oberrow/i8088-computer/kicad/Intel_8088_Computer/3dmodels/USB4110-GF-A.step

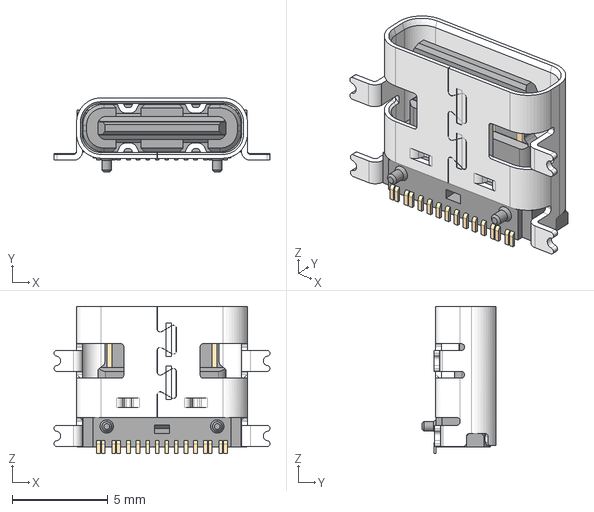
[picture p1: CAD file, 2026-07-20]
kicad/Intel_8088_Computer/3dmodels/USB4110-GF-A.step
11.3 x 3.89 x 7.70 mm
