oberrow/i8088-computer/kicad/Intel_8088_Computer/3dmodels/97503A111_Stainless Steel Phillips Oval Head Thread-Cutting Screws.STEP

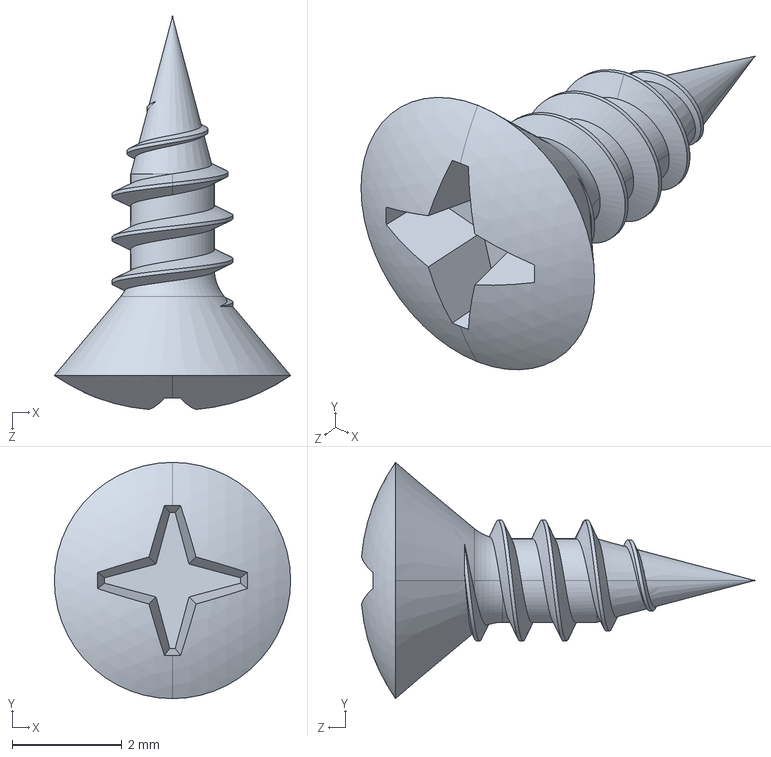
[picture p2: CAD file, 2026-07-20]
kicad/Intel_8088_Computer/3dmodels/97503A111_Stainless Steel Phillips Oval Head Thread-Cutting Screws.STEP
4.30 x 4.30 x 7.15 mm
