oberrow/i8088-computer/kicad/UART_Unit/UART_Unit.kicad_pcb

## KiCad design kicad/UART_Unit/UART_Unit.kicad_pcb (2026-07-20)

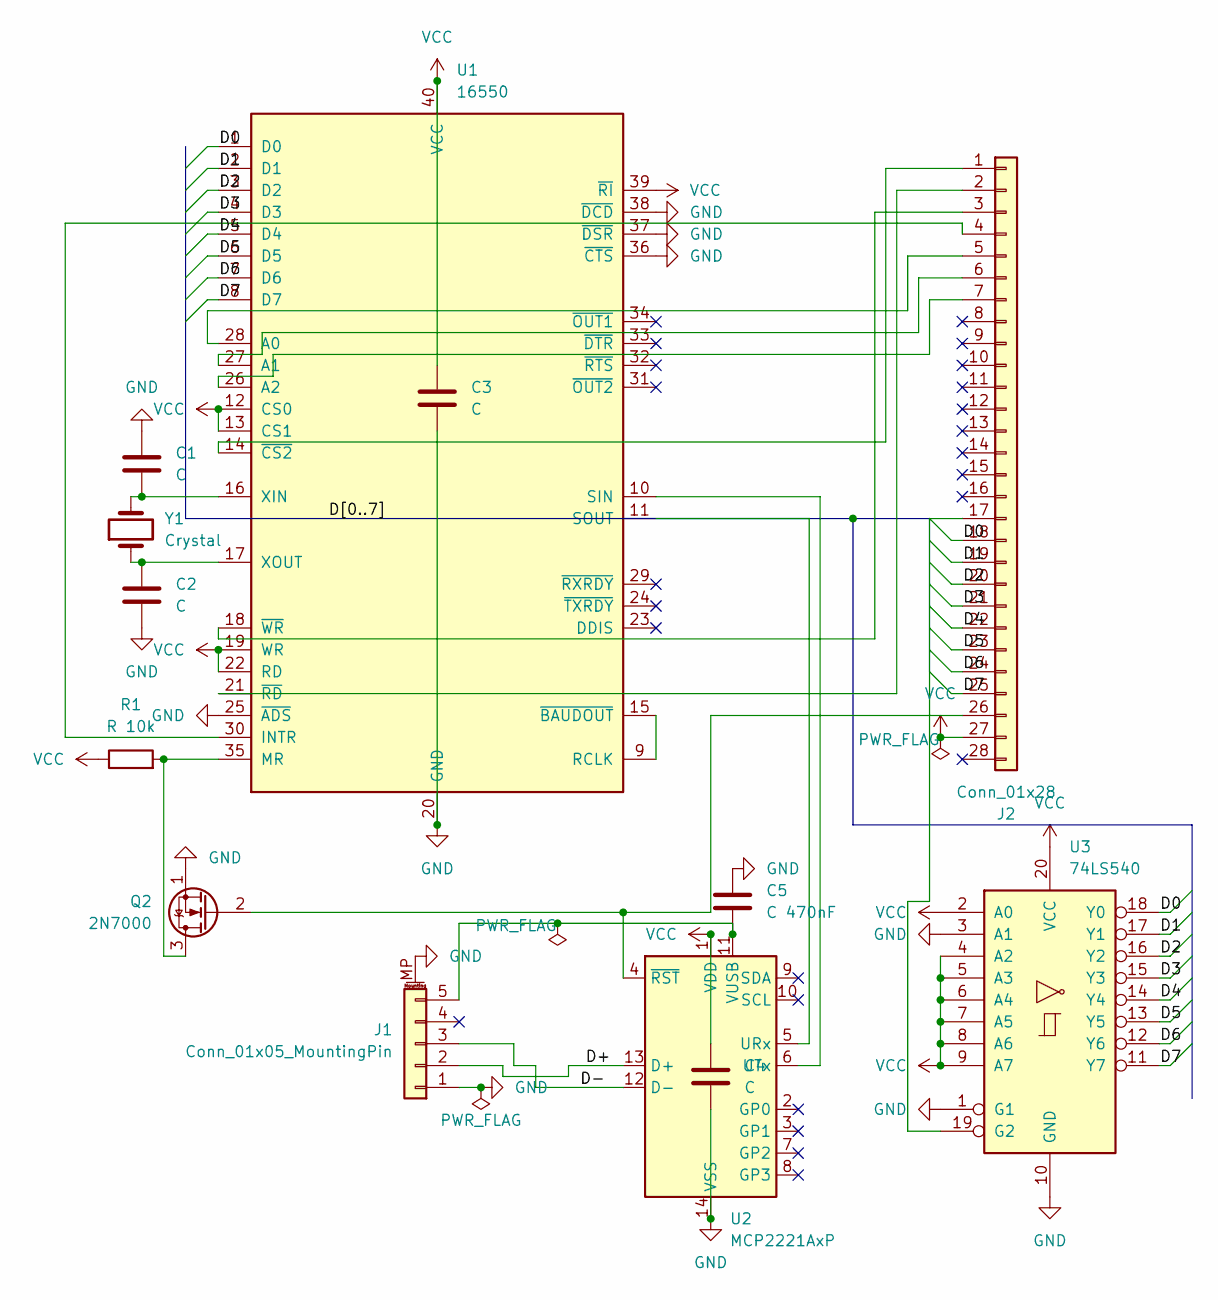
[picture p3: schematic UART_Unit.kicad_sch]

Parts:
C1, C2: C; C_Disc_D5.0mm_W2.5mm_P5.00mm
C3, C4: C; C_Disc_D5.0mm_W2.5mm_P2.50mm
C5: C 470nF; C_Disc_D5.0mm_W2.5mm_P2.50mm
J1: Conn_01x05_MountingPin; Molex_200528-0050_1x05-1MP_P1.00mm_Horizontal
J2: Conn_01x28; PinHeader_2x14_P2.54mm_Vertical
Q2: 2N7000; TO-92_Inline
R1: R 10k; R_Axial_DIN0207_L6.3mm_D2.5mm_P10.16mm_Horizontal
U1: 16550; DIP-40_W15.24mm
U2: MCP2221AxP; DIP-14_W7.62mm
U3: 74LS540; DIP-20_W7.62mm
Y1: Crystal; Crystal_HC49-U_Vertical

Connections:
/D0: J2.18, U1.1 (D0), U3.18 (Y0)
/D1: J2.19, U1.2 (D1), U3.17 (Y1)
/D2: J2.20, U1.3 (D2), U3.16 (Y2)
/D3: J2.21, U1.4 (D3), U3.15 (Y3)
/D4: J2.22, U1.5 (D4), U3.14 (Y4)
/D5: J2.23, U1.6 (D5), U3.13 (Y5)
/D6: J2.24, U1.7 (D6), U3.12 (Y6)
/D7: J2.25, U1.8 (D7), U3.11 (Y7)
/D+: J1.2, U2.13 (D+)
/D-: J1.3, U2.12 (D-)
GND: C1.1, C2.2, C3.2, C4.2, C5.1, J1.1, J1.MP (MountPin), Q2.1 (S), U1.20 (GND), U1.25 (~ADS), U1.36 (~CTS), U1.37 (~DSR), U1.38 (~DCD), U2.14 (VSS), U3.1 (G1), U3.3 (A1), U3.10 (GND)
unnamed: C5.2, J1.5, U2.11 (VUSB)
unnamed: J2.1, U1.14 (~CS2)
unnamed: J2.2, U1.21 (~RD)
unnamed: J2.3, U1.18 (~WR)
unnamed: J2.4, U1.30 (INTR)
unnamed: J2.5, U1.28 (A0)
unnamed: J2.6, U1.27 (A1)
unnamed: J2.7, U1.26 (A2)
unnamed: J2.17, U3.19 (G2)
unnamed: J2.26, Q2.2 (G), U2.4 (~RST)
unnamed: Q2.3 (D), R1.2, U1.35 (MR)
unnamed: U1.9 (RCLK), U1.15 (~BAUDOUT)
unnamed: U1.10 (SIN), U2.6 (UTx)
unnamed: U1.11 (SOUT), U2.5 (URx)
unnamed: C1.2, U1.16 (XIN), Y1.2
unnamed: C2.1, U1.17 (XOUT), Y1.1
VCC: C3.1, C4.1, J2.27, R1.1, U1.12 (CS0), U1.13 (CS1), U1.19 (WR), U1.22 (RD), U1.39 (~RI), U1.40 (VCC), U2.1 (VDD), U3.2 (A0), U3.4 (A2), U3.5 (A3), U3.6 (A4), U3.7 (A5), U3.8 (A6), U3.9 (A7), U3.20 (VCC)

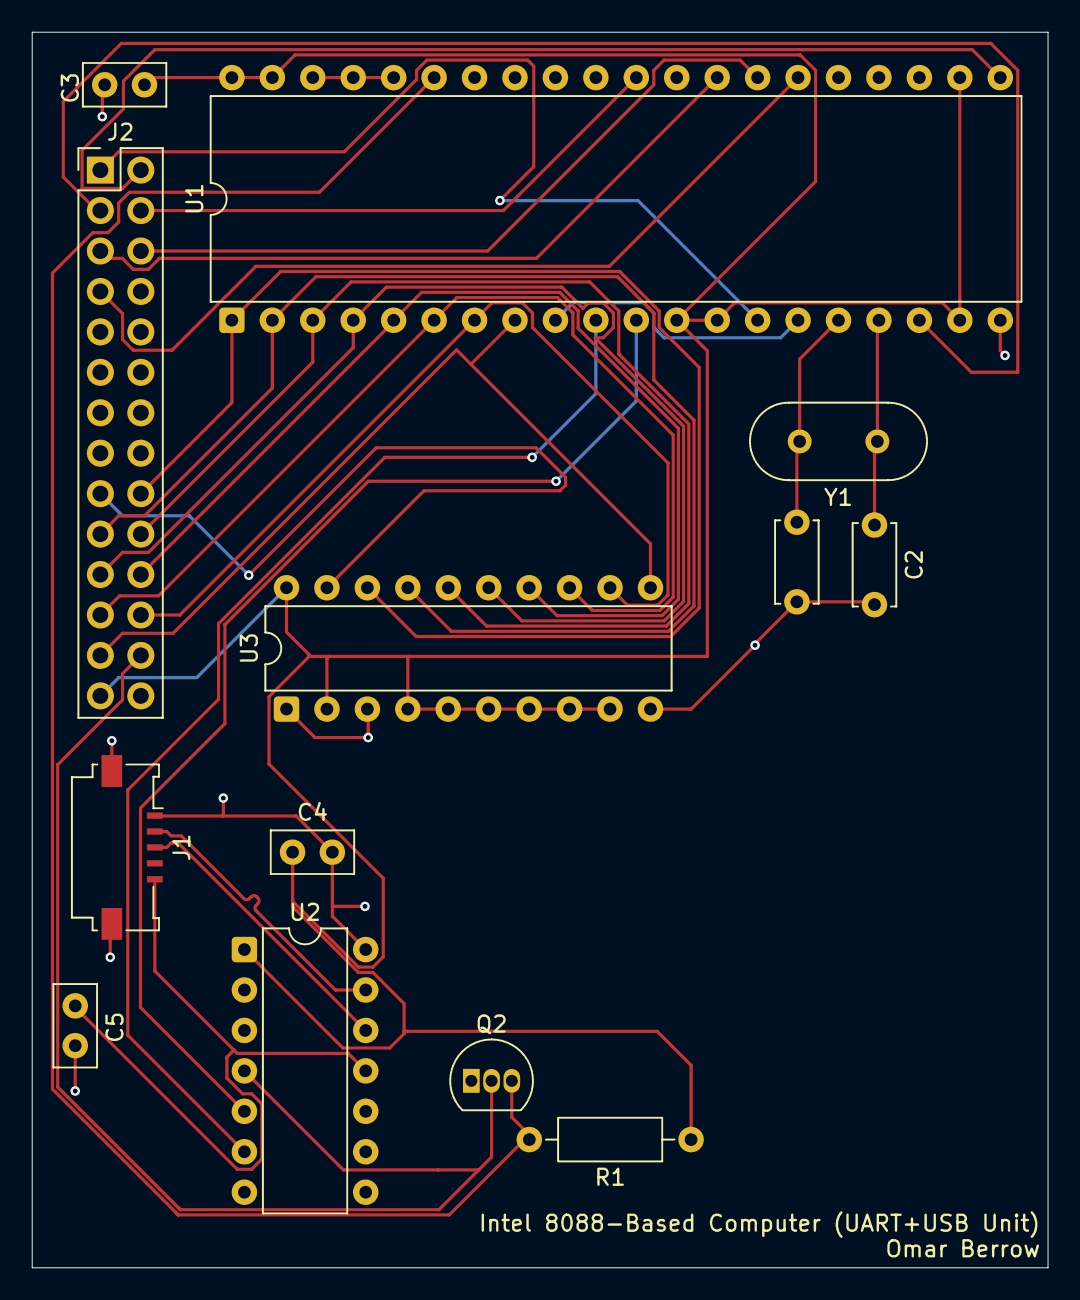
[picture p4: board UART_Unit.kicad_pcb from above]

Board: 2 copper layers, 63.8 x 77.6 mm, 13 parts (0 on the bottom side), 28 nets.
