oberrow/i8088-computer/kicad/AS6C1008_RAM_Unit/AS6C1008_RAM_Unit.kicad_pcb

## KiCad design kicad/AS6C1008_RAM_Unit/AS6C1008_RAM_Unit.kicad_pcb (2026-07-20)

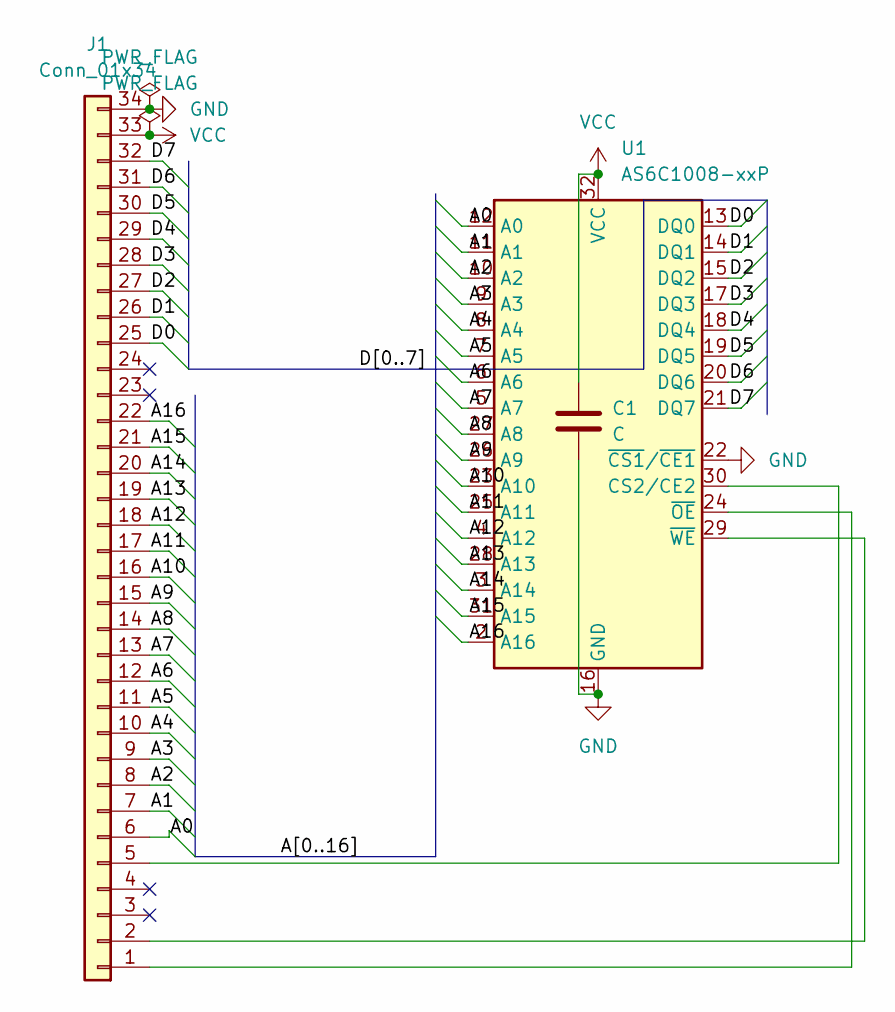
[picture p5: schematic AS6C1008_RAM_Unit.kicad_sch]

Parts:
C1: C; C_Disc_D5.0mm_W2.5mm_P2.50mm
J1: Conn_01x34; PinHeader_2x17_P2.54mm_Vertical
U1: AS6C1008-xxP; DIP-32_W15.24mm

Connections:
/A0: J1.6, U1.12 (A0)
/A1: J1.7, U1.11 (A1)
/A2: J1.8, U1.10 (A2)
/A3: J1.9, U1.9 (A3)
/A4: J1.10, U1.8 (A4)
/A5: J1.11, U1.7 (A5)
/A6: J1.12, U1.6 (A6)
/A7: J1.13, U1.5 (A7)
/A8: J1.14, U1.27 (A8)
/A9: J1.15, U1.26 (A9)
/A10: J1.16, U1.23 (A10)
/A11: J1.17, U1.25 (A11)
/A12: J1.18, U1.4 (A12)
/A13: J1.19, U1.28 (A13)
/A14: J1.20, U1.3 (A14)
/A15: J1.21, U1.31 (A15)
/A16: J1.22, U1.2 (A16)
/D0: J1.25, U1.13 (DQ0)
/D1: J1.26, U1.14 (DQ1)
/D2: J1.27, U1.15 (DQ2)
/D3: J1.28, U1.17 (DQ3)
/D4: J1.29, U1.18 (DQ4)
/D5: J1.30, U1.19 (DQ5)
/D6: J1.31, U1.20 (DQ6)
/D7: J1.32, U1.21 (DQ7)
GND: C1.2, J1.34, U1.16 (GND), U1.22 (~CS1/~CE1)
unnamed: J1.1, U1.24 (~OE)
unnamed: J1.2, U1.29 (~WE)
unnamed: J1.5, U1.30 (CS2/CE2)
VCC: C1.1, J1.33, U1.32 (VCC)

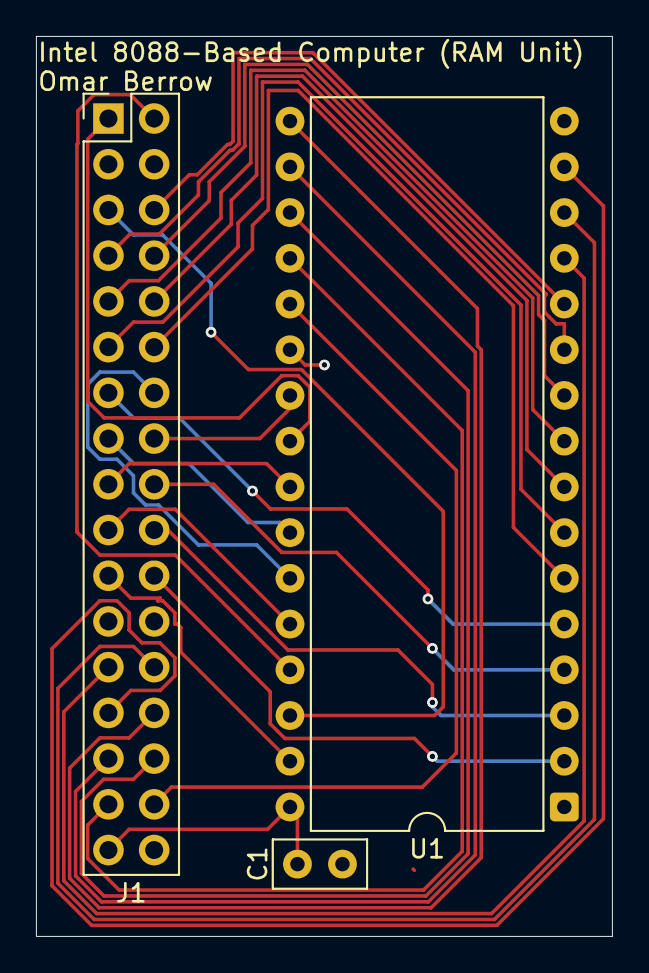
[picture p6: board AS6C1008_RAM_Unit.kicad_pcb from above]

Board: 2 copper layers, 32.0 x 50.0 mm, 3 parts (0 on the bottom side), 30 nets.
