oberrow/i8088-computer/kicad/Timer_Unit/Timer_Unit.kicad_pcb

## KiCad design kicad/Timer_Unit/Timer_Unit.kicad_pcb (2026-07-20)

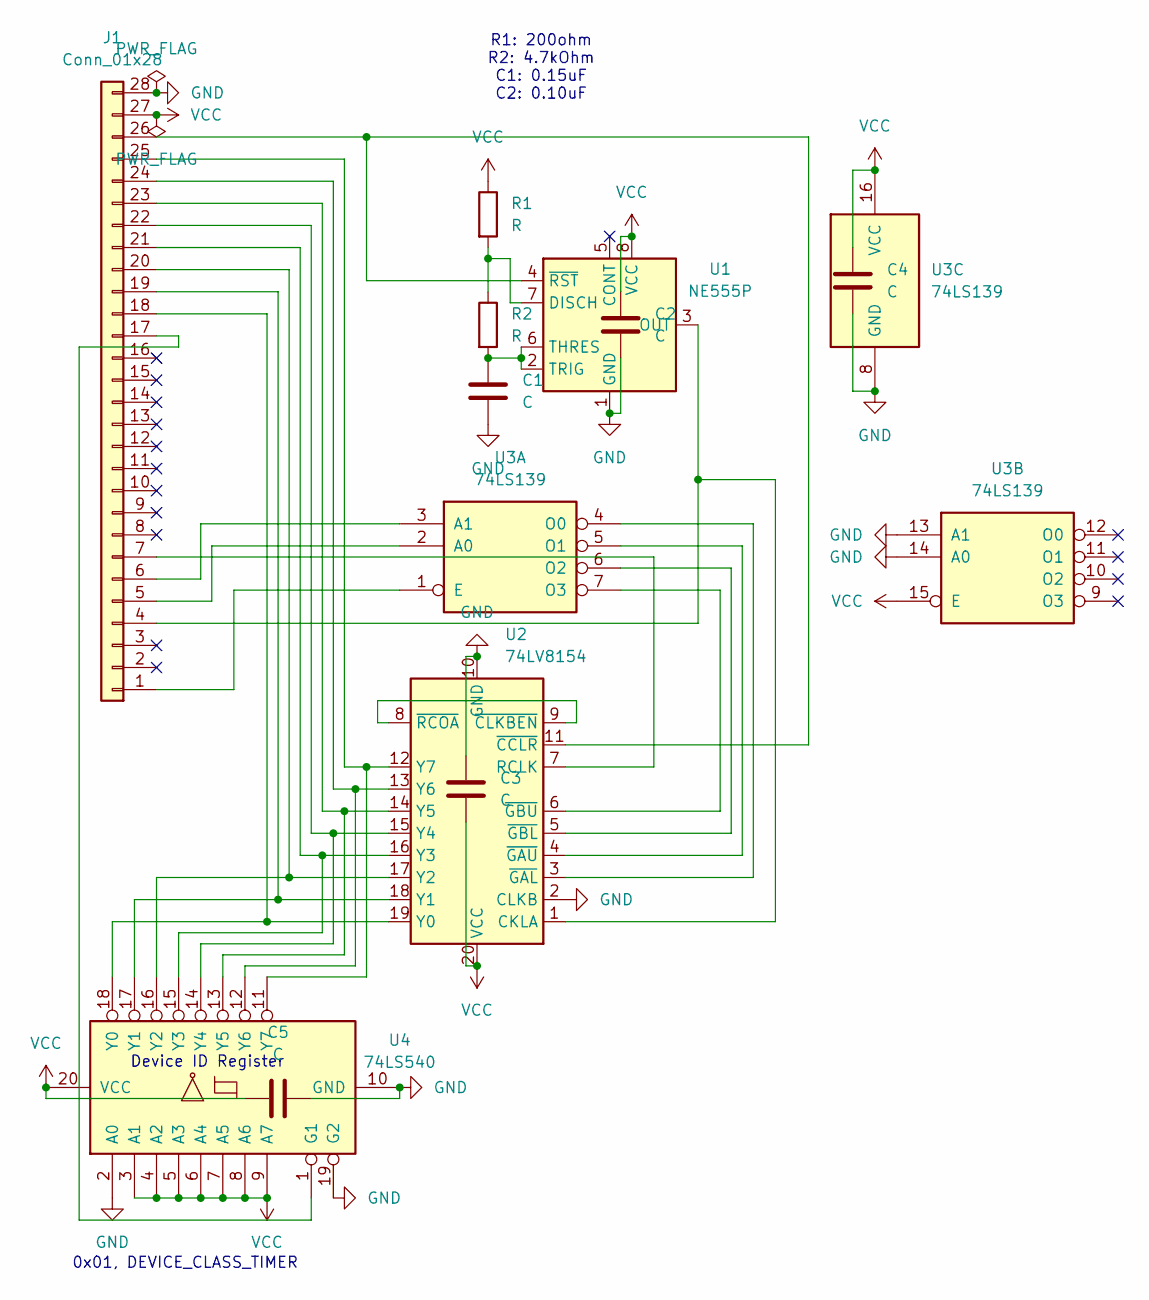
[picture p7: schematic Timer_Unit.kicad_sch]

Parts:
C1, C2, C3, C4, C5: C; C_Disc_D5.0mm_W2.5mm_P2.50mm
J1: Conn_01x28; PinHeader_2x14_P2.54mm_Vertical
R1, R2: R; R_Axial_DIN0207_L6.3mm_D2.5mm_P10.16mm_Horizontal
U1: NE555P; DIP-8_W7.62mm
U2: 74LV8154; DIP-20_W7.62mm
U3: 74LS139; DIP-16_W7.62mm
U4: 74LS540; DIP-20_W7.62mm

Connections:
GND: C1.2, C2.2, C3.1, C4.2, C5.2, J1.28, U1.1 (GND), U2.2 (CLKB), U2.10 (GND), U3.8 (GND), U3.13 (A1), U3.14 (A0), U4.2 (A0), U4.10 (GND), U4.19 (G2)
unnamed: J1.1, U3.1 (E)
unnamed: J1.4, U1.3 (OUT), U2.1 (CKLA)
unnamed: J1.5, U3.2 (A0)
unnamed: J1.6, U3.3 (A1)
unnamed: J1.7, U2.7 (RCLK)
unnamed: J1.17, U4.1 (G1)
unnamed: J1.18, U2.19 (Y0), U4.18 (Y0)
unnamed: J1.19, U2.18 (Y1), U4.17 (Y1)
unnamed: J1.20, U2.17 (Y2), U4.16 (Y2)
unnamed: J1.21, U2.16 (Y3), U4.15 (Y3)
unnamed: J1.22, U2.15 (Y4), U4.14 (Y4)
unnamed: J1.23, U2.14 (Y5), U4.13 (Y5)
unnamed: J1.24, U2.13 (Y6), U4.12 (Y6)
unnamed: J1.25, U2.12 (Y7), U4.11 (Y7)
unnamed: J1.26, U1.4 (~RST), U2.11 (~CCLR)
unnamed: R1.2, R2.1, U1.7 (DISCH)
unnamed: C1.1, R2.2, U1.2 (TRIG), U1.6 (THRES)
unnamed: U2.8 (~RCOA), U2.9 (~CLKBEN)
unnamed: U2.3 (~GAL), U3.4 (O0)
unnamed: U2.4 (~GAU), U3.5 (O1)
unnamed: U2.5 (~GBL), U3.6 (O2)
unnamed: U2.6 (~GBU), U3.7 (O3)
VCC: C2.1, C3.2, C4.1, C5.1, J1.27, R1.1, U1.8 (VCC), U2.20 (VCC), U3.15 (E), U3.16 (VCC), U4.3 (A1), U4.4 (A2), U4.5 (A3), U4.6 (A4), U4.7 (A5), U4.8 (A6), U4.9 (A7), U4.20 (VCC)

Notes on the sheet:
R1: 200ohm R2: 4.7kOhm C1: 0.15uF C2: 0.10uF
Device ID Register
0x01, DEVICE_CLASS_TIMER

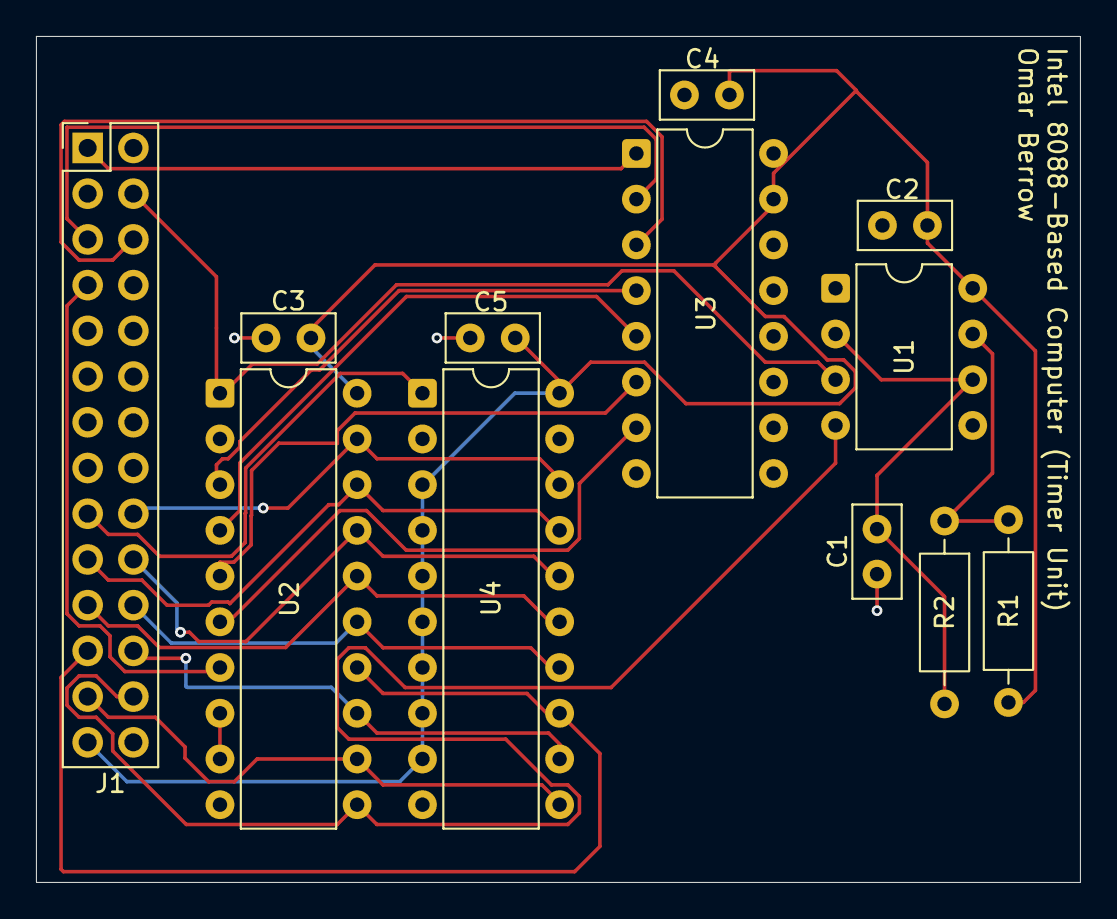
[picture p8: board Timer_Unit.kicad_pcb from above]

Board: 2 copper layers, 58.0 x 47.0 mm, 12 parts (0 on the bottom side), 24 nets.
