oberrow/i8088-computer/kicad/82C55_GPIO_Unit/82C55_GPIO_Unit.kicad_pcb

## KiCad design kicad/82C55_GPIO_Unit/82C55_GPIO_Unit.kicad_pcb (2026-07-20)

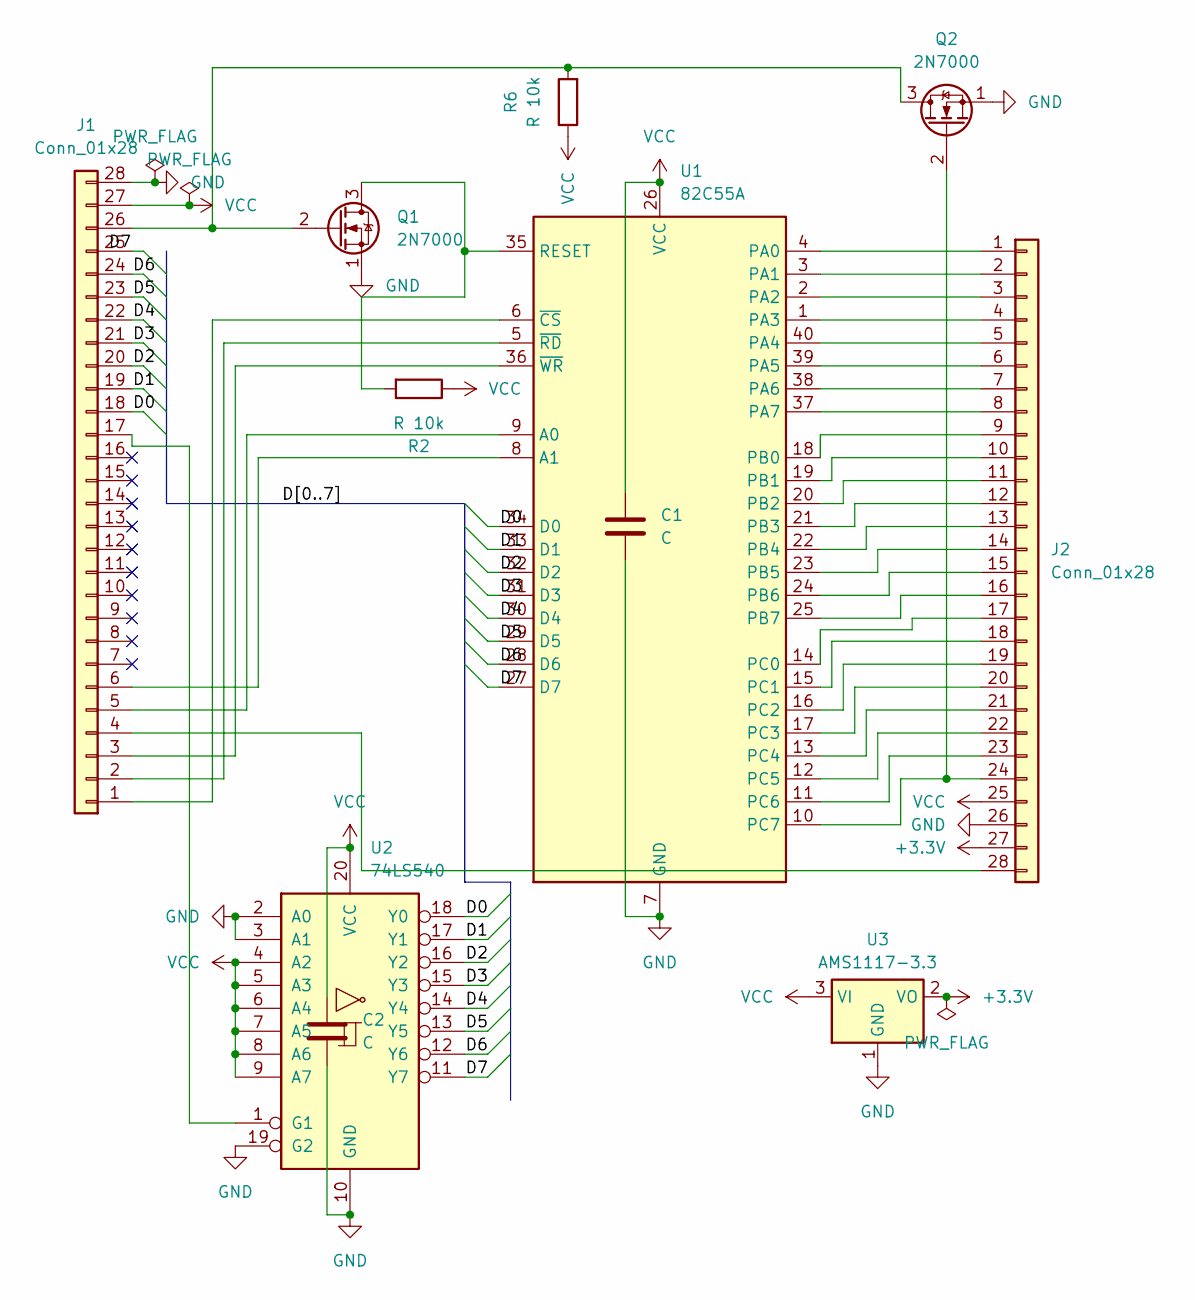
[picture p9: schematic 82C55_GPIO_Unit.kicad_sch]

Parts:
C1, C2: C; C_Disc_D5.0mm_W2.5mm_P2.50mm
J1, J2: Conn_01x28; PinHeader_2x14_P2.54mm_Vertical
Q1, Q2: 2N7000; TO-92_Inline
R2, R6: R 10k; R_Axial_DIN0207_L6.3mm_D2.5mm_P10.16mm_Horizontal
U1: 82C55A; DIP-40_W15.24mm
U2: 74LS540; DIP-20_W7.62mm
U3: AMS1117-3.3; SOT-223-3_TabPin2

Connections:
+3.3V: J2.27, U3.2 (VO)
/D0: J1.18, U1.34 (D0), U2.18 (Y0)
/D1: J1.19, U1.33 (D1), U2.17 (Y1)
/D2: J1.20, U1.32 (D2), U2.16 (Y2)
/D3: J1.21, U1.31 (D3), U2.15 (Y3)
/D4: J1.22, U1.30 (D4), U2.14 (Y4)
/D5: J1.23, U1.29 (D5), U2.13 (Y5)
/D6: J1.24, U1.28 (D6), U2.12 (Y6)
/D7: J1.25, U1.27 (D7), U2.11 (Y7)
GND: C1.2, C2.2, J1.28, J2.26, Q1.1 (S), Q2.1 (S), U1.7 (GND), U2.2 (A0), U2.3 (A1), U2.10 (GND), U2.19 (G2), U3.1 (GND)
unnamed: J1.1, U1.6 (~CS)
unnamed: J1.2, U1.5 (~RD)
unnamed: J1.3, U1.36 (~WR)
unnamed: J1.4, J2.28
unnamed: J1.5, U1.9 (A0)
unnamed: J1.6, U1.8 (A1)
unnamed: J1.17, U2.1 (G1)
unnamed: J1.26, Q1.2 (G), Q2.3 (D), R6.2
unnamed: J2.1, U1.4 (PA0)
unnamed: J2.2, U1.3 (PA1)
unnamed: J2.3, U1.2 (PA2)
unnamed: J2.4, U1.1 (PA3)
unnamed: J2.5, U1.40 (PA4)
unnamed: J2.6, U1.39 (PA5)
unnamed: J2.7, U1.38 (PA6)
unnamed: J2.8, U1.37 (PA7)
unnamed: J2.9, U1.18 (PB0)
unnamed: J2.10, U1.19 (PB1)
unnamed: J2.11, U1.20 (PB2)
unnamed: J2.12, U1.21 (PB3)
unnamed: J2.13, U1.22 (PB4)
unnamed: J2.14, U1.23 (PB5)
unnamed: J2.15, U1.24 (PB6)
unnamed: J2.16, U1.25 (PB7)
unnamed: J2.17, U1.14 (PC0)
unnamed: J2.18, U1.15 (PC1)
unnamed: J2.19, U1.16 (PC2)
unnamed: J2.20, U1.17 (PC3)
unnamed: J2.21, U1.13 (PC4)
unnamed: J2.22, U1.12 (PC5)
unnamed: J2.23, U1.11 (PC6)
unnamed: J2.24, Q2.2 (G), U1.10 (PC7)
unnamed: Q1.3 (D), R2.2, U1.35 (RESET)
VCC: C1.1, C2.1, J1.27, J2.25, R2.1, R6.1, U1.26 (VCC), U2.4 (A2), U2.5 (A3), U2.6 (A4), U2.7 (A5), U2.8 (A6), U2.9 (A7), U2.20 (VCC), U3.3 (VI)

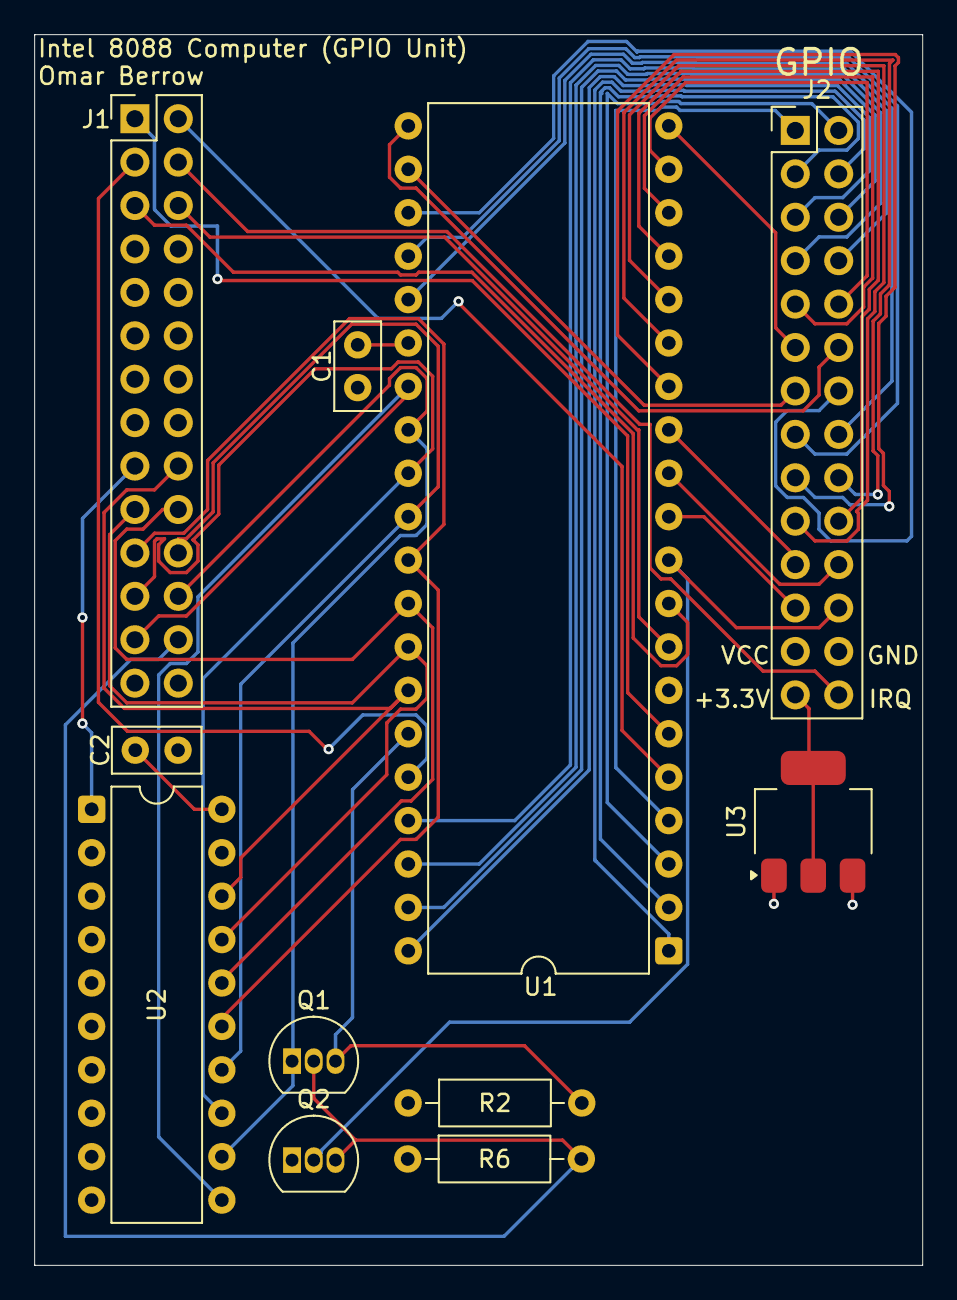
[picture p10: board 82C55_GPIO_Unit.kicad_pcb from above]

Board: 4 copper layers, 52.0 x 72.0 mm, 11 parts (0 on the bottom side), 44 nets.
