oberrow/i8088-computer/kicad/SPI_Unit/SPI_Unit.kicad_pcb

## KiCad design kicad/SPI_Unit/SPI_Unit.kicad_pcb (2026-07-20)

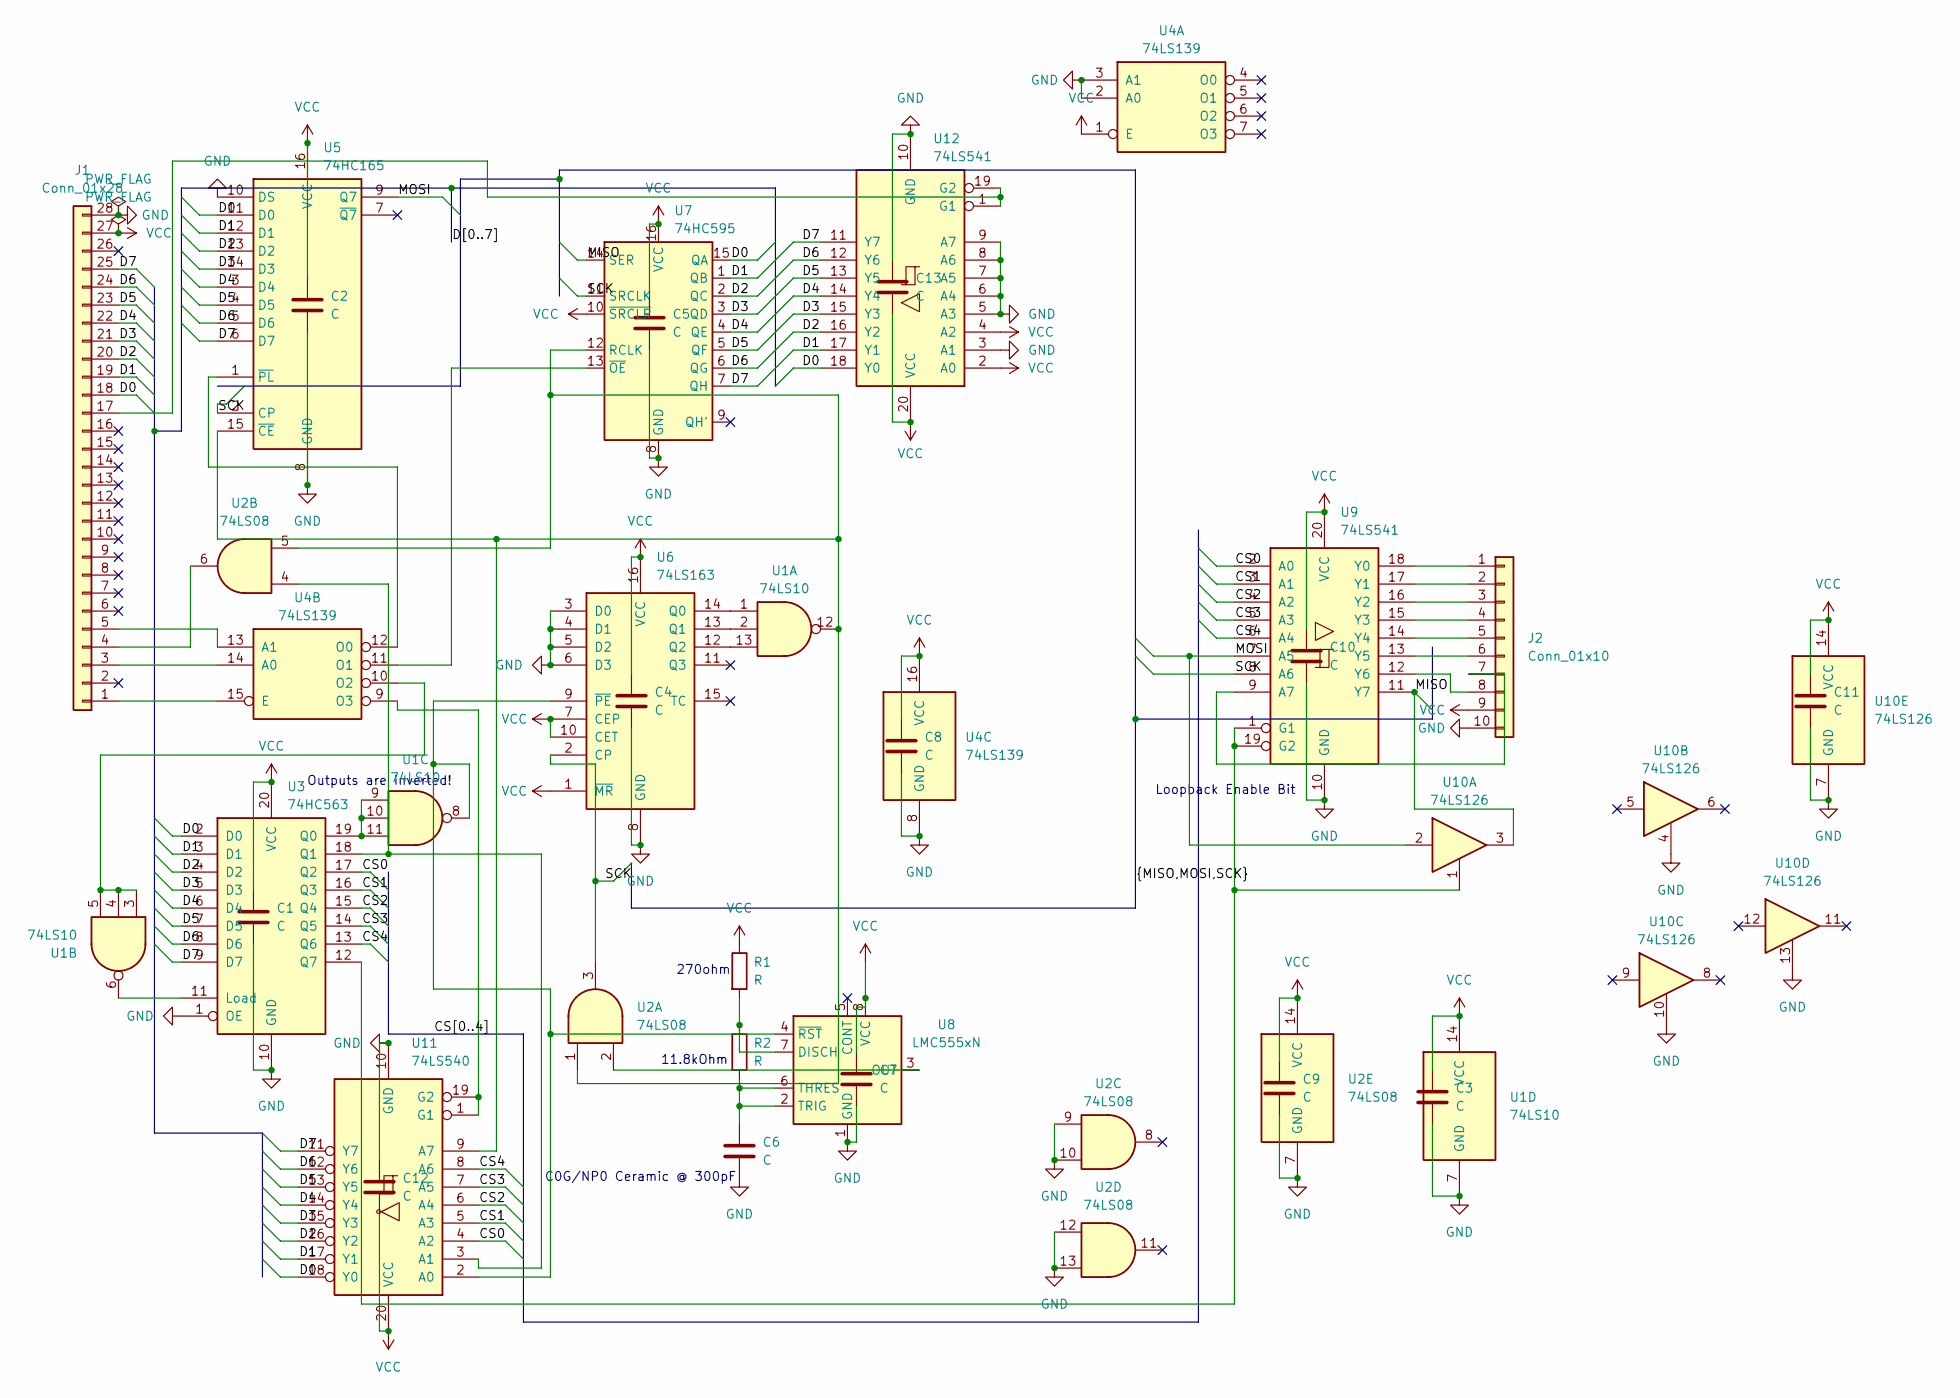
[picture p11: schematic SPI_Unit.kicad_sch]

Parts:
C1, C2, C3, C4, C5, C6, C7, C8, C9, C10, C11, C12, C13: C; C_Disc_D5.0mm_W2.5mm_P2.50mm
J1: Conn_01x28; PinHeader_2x14_P2.54mm_Vertical
J2: Conn_01x10; PinHeader_1x10_P2.54mm_Vertical
R1, R2: R; R_Axial_DIN0207_L6.3mm_D2.5mm_P7.62mm_Horizontal
U1: 74LS10; DIP-14_W7.62mm
U2: 74LS08; DIP-14_W7.62mm
U3: 74HC563; DIP-20_W7.62mm
U4: 74LS139; DIP-16_W7.62mm
U5: 74HC165; DIP-16_W7.62mm
U6: 74LS163; DIP-16_W7.62mm
U7: 74HC595; DIP-16_W7.62mm
U8: LMC555xN; DIP-8_W7.62mm
U9, U12: 74LS541; DIP-20_W7.62mm
U10: 74LS126; DIP-14_W7.62mm
U11: 74LS540; DIP-20_W7.62mm

Connections:
/CS0: U3.17 (Q2), U9.2 (A0), U11.4 (A2)
/CS1: U3.16 (Q3), U9.3 (A1), U11.5 (A3)
/CS2: U3.15 (Q4), U9.4 (A2), U11.6 (A4)
/CS3: U3.14 (Q5), U9.5 (A3), U11.7 (A5)
/CS4: U3.13 (Q6), U9.6 (A4), U11.8 (A6)
/D0: J1.18, U3.2 (D0), U5.11 (D0), U7.15 (QA), U11.18 (Y0), U12.18 (Y0)
/D1: J1.19, U3.3 (D1), U5.12 (D1), U7.1 (QB), U11.17 (Y1), U12.17 (Y1)
/D2: J1.20, U3.4 (D2), U5.13 (D2), U7.2 (QC), U11.16 (Y2), U12.16 (Y2)
/D3: J1.21, U3.5 (D3), U5.14 (D3), U7.3 (QD), U11.15 (Y3), U12.15 (Y3)
/D4: J1.22, U3.6 (D4), U5.3 (D4), U7.4 (QE), U11.14 (Y4), U12.14 (Y4)
/D5: J1.23, U3.7 (D5), U5.4 (D5), U7.5 (QF), U11.13 (Y5), U12.13 (Y5)
/D6: J1.24, U3.8 (D6), U5.5 (D6), U7.6 (QG), U11.12 (Y6), U12.12 (Y6)
/D7: J1.25, U3.9 (D7), U5.6 (D7), U7.7 (QH), U11.11 (Y7), U12.11 (Y7)
/MISO: U7.14 (SER), U9.11 (Y7), U10.3
/MOSI: U5.9 (Q7), U9.7 (A5), U10.2
/SCK: U2.3, U5.2 (CP), U6.2 (CP), U7.11 (SRCLK), U9.8 (A6)
GND: C1.2, C2.2, C3.2, C4.2, C5.2, C6.2, C7.2, C8.2, C9.2, C10.2, C11.2, C12.1, C13.1, J1.28, J2.10, U1.7 (GND), U2.7 (GND), U2.9, U2.10, U2.12, U2.13, U3.1 (OE), U3.10 (GND), U4.2 (A0), U4.3 (A1), U4.8 (GND), U5.8 (GND), U5.10 (DS), U6.3 (D0), U6.4 (D1), U6.5 (D2), U6.6 (D3), U6.8 (GND), U7.8 (GND), U8.1 (GND), U9.10 (GND), U10.4, U10.7 (GND), U10.10, U10.13, U11.10 (GND), U12.3 (A1), U12.5 (A3), U12.6 (A4), U12.7 (A5), U12.8 (A6), U12.9 (A7), U12.10 (GND)
unnamed: J1.1, U4.15 (E)
unnamed: J1.3, U4.14 (A0)
unnamed: J1.4, U2.6
unnamed: J1.5, U4.13 (A1)
unnamed: J1.17, U12.1 (G1), U12.19 (G2)
unnamed: J2.1, U9.18 (Y0)
unnamed: J2.2, U9.17 (Y1)
unnamed: J2.3, U9.16 (Y2)
unnamed: J2.4, U9.15 (Y3)
unnamed: J2.5, U9.14 (Y4)
unnamed: J2.6, U9.13 (Y5)
unnamed: J2.7, U9.9 (A7)
unnamed: J2.8, U9.12 (Y6)
unnamed: U1.6, U3.11 (Load)
unnamed: U1.9, U1.10, U1.11, U3.19 (Q0)
unnamed: U3.12 (Q7), U9.1 (G1), U9.19 (G2), U10.1
unnamed: U4.12 (O0), U5.1 (~PL)
unnamed: U4.11 (O1), U7.13 (~OE)
unnamed: U1.3, U1.4, U1.5, U4.10 (O2)
unnamed: U1.1, U6.14 (Q0)
unnamed: U1.2, U6.13 (Q1)
unnamed: U1.13, U6.12 (Q2)
unnamed: R1.2, R2.1, U8.7 (DISCH)
unnamed: U2.2, U8.3 (OUT)
unnamed: C6.1, R2.2, U8.2 (TRIG), U8.6 (THRES)
unnamed: U1.8, U6.9 (~PE), U8.4 (~RST), U11.2 (A0)
unnamed: U2.4, U3.18 (Q1), U11.3 (A1)
unnamed: U1.12, U2.1, U2.5, U5.15 (~CE), U7.12 (RCLK), U11.9 (A7)
unnamed: U4.9 (O3), U11.1 (G1), U11.19 (G2)
VCC: C1.1, C2.1, C3.1, C4.1, C5.1, C7.1, C8.1, C9.1, C10.1, C11.1, C12.2, C13.2, J1.27, J2.9, R1.1, U1.14 (VCC), U2.14 (VCC), U3.20 (VCC), U4.1 (E), U4.16 (VCC), U5.16 (VCC), U6.1 (~MR), U6.7 (CEP), U6.10 (CET), U6.16 (VCC), U7.10 (~SRCLR), U7.16 (VCC), U8.8 (VCC), U9.20 (VCC), U10.14 (VCC), U11.20 (VCC), U12.2 (A0), U12.4 (A2), U12.20 (VCC)

Notes on the sheet:
Loopback Enable Bit
C0G/NP0 Ceramic @ 300pF
270ohm
Outputs are inverted!
11.8kOhm

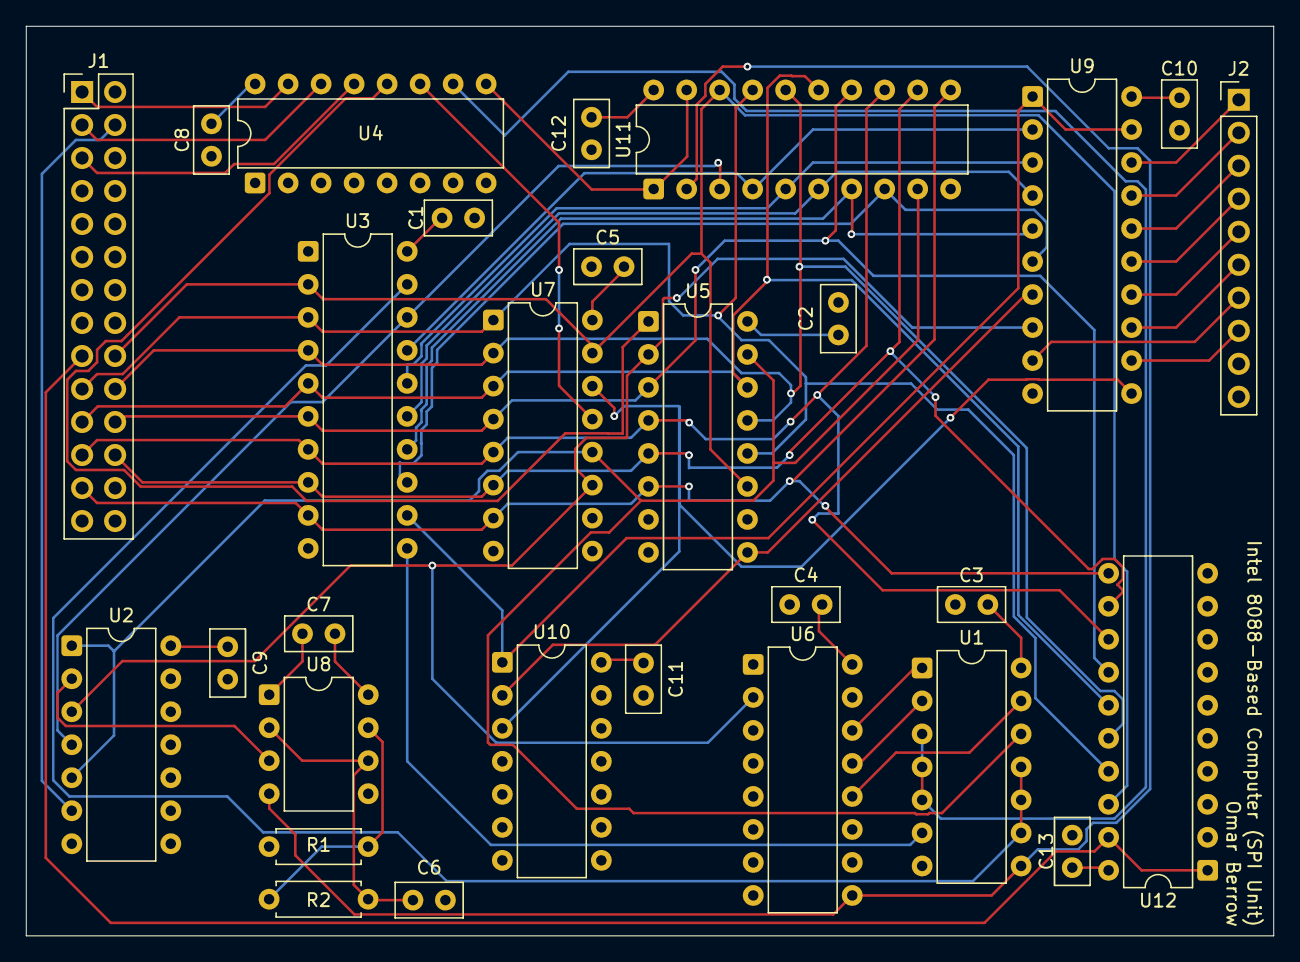
[picture p12: board SPI_Unit.kicad_pcb from above]

Board: 4 copper layers, 96.0 x 70.0 mm, 29 parts (0 on the bottom side), 47 nets.
