oberrow/i8088-computer/kicad/Intel_8088_Computer/Intel_8088_Computer.kicad_pcb

## KiCad design kicad/Intel_8088_Computer/Intel_8088_Computer.kicad_pcb (2026-07-20)

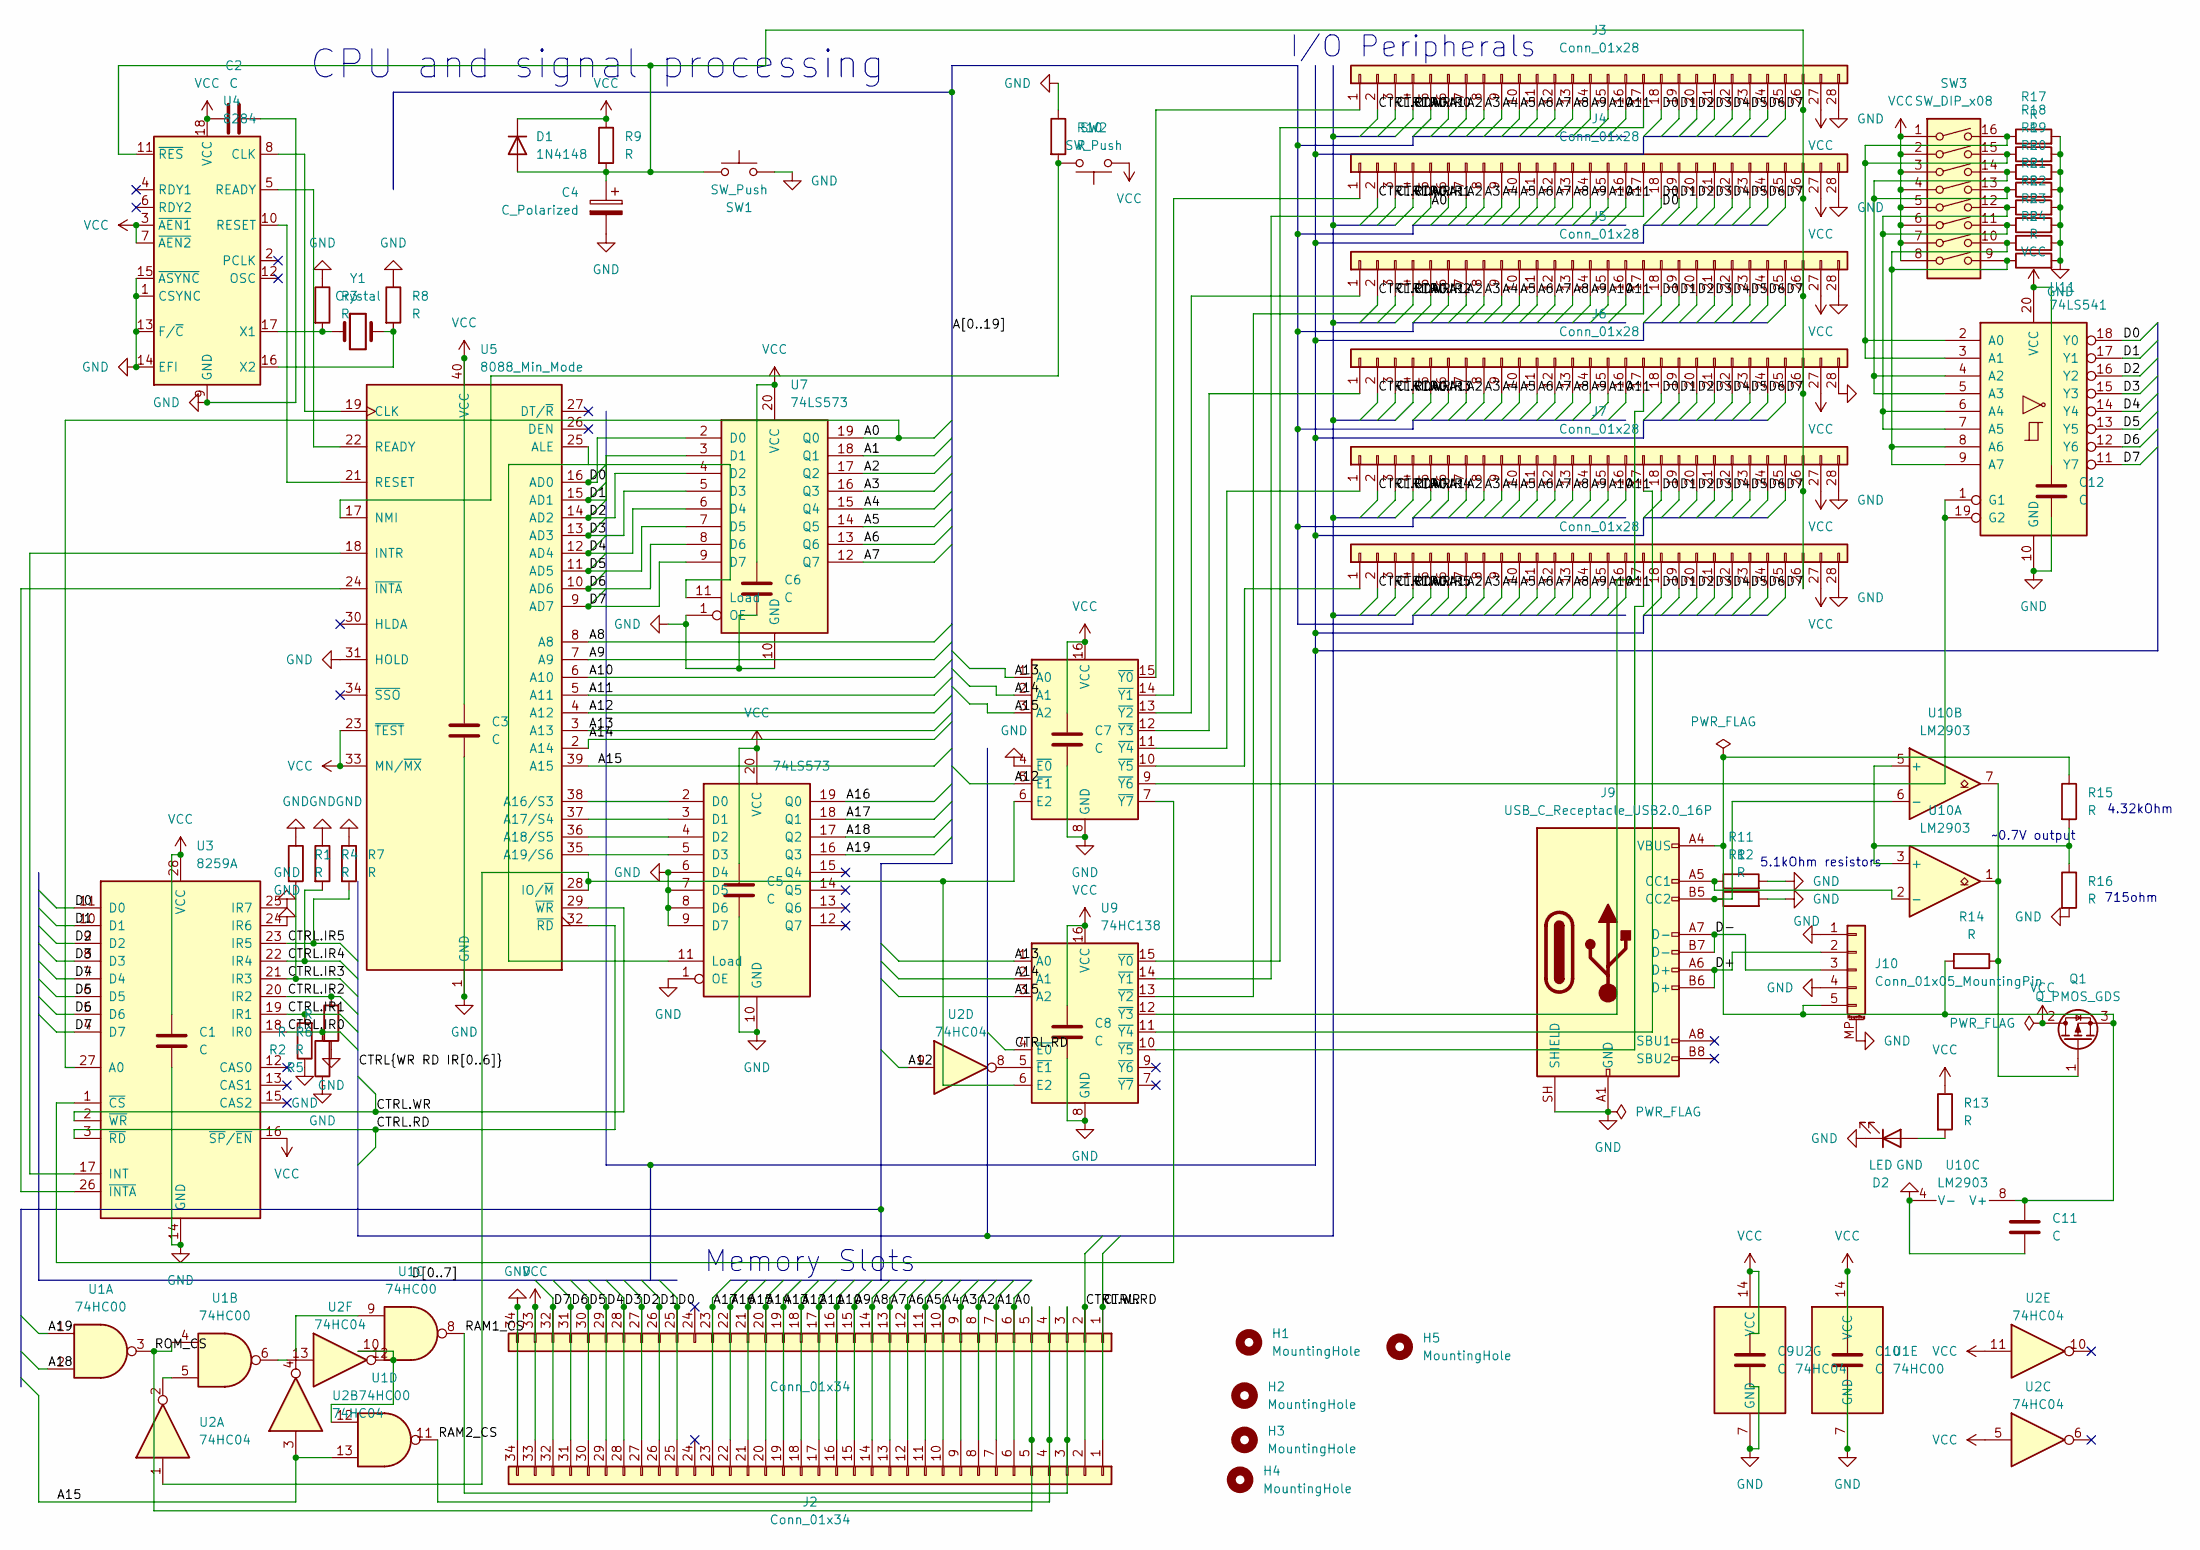
[picture p13: schematic Intel_8088_Computer.kicad_sch]

Parts:
C1, C2, C3, C5, C6, C7, C8, C9, C10, C11, C12: C; C_Disc_D5.0mm_W2.5mm_P2.50mm
C4: C_Polarized; CP_Radial_D5.0mm_P2.00mm
D1: 1N4148; D_DO-35_SOD27_P7.62mm_Horizontal
D2: LED; LED_D3.0mm
H1, H2, H3, H4, H5: MountingHole; MountingHole_2.2mm_M2
J1, J2: Conn_01x34; PinHeader_2x17_P2.54mm_Vertical
J3, J4, J5, J6, J7, J8: Conn_01x28; PinHeader_2x14_P2.54mm_Vertical
J9: USB_C_Receptacle_USB2.0_16P; USB_C_Receptacle_GCT_USB4085
J10: Conn_01x05_MountingPin; Molex_200528-0050_1x05-1MP_P1.00mm_Horizontal
Q1: Q_PMOS_GDS; TO-220-3_Vertical
R1, R2, R3, R4, R5, R6, R7, R8, R9, R10, R11, R12, R13, R14, R15, R16, R17, R18, R19, R20, R21, R22, R23, R24: R; R_Axial_DIN0207_L6.3mm_D2.5mm_P7.62mm_Horizontal
SW1, SW2: SW_Push; SW_PUSH_6mm
SW3: SW_DIP_x08; SW_DIP_SPSTx08_Slide_6.7x21.88mm_W7.62mm_P2.54mm_LowProfile
U1: 74HC00; DIP-14_W7.62mm
U2: 74HC04; DIP-14_W7.62mm
U3: 8259A; DIP-28_W15.24mm
U4: 8284; DIP-18_W7.62mm
U5: 8088_Min_Mode; DIP-40_W15.24mm
U6, U7: 74LS573; DIP-20_W7.62mm
U8, U9: 74HC138; DIP-16_W7.62mm
U10: LM2903; DIP-8_W7.62mm
U11: 74LS541; DIP-20_W7.62mm
Y1: Crystal; Crystal_HC49-U_Vertical

Connections:
/A0: J1.6, J2.6, J3.5, J4.5, J5.5, J6.5, J7.5, J8.5, U3.27 (A0), U7.19 (Q0)
/A1: J1.7, J2.7, J3.6, J4.6, J5.6, J6.6, J7.6, J8.6, U7.18 (Q1)
/A2: J1.8, J2.8, J3.7, J4.7, J5.7, J6.7, J7.7, J8.7, U7.17 (Q2)
/A3: J1.9, J2.9, J3.8, J4.8, J5.8, J6.8, J7.8, J8.8, U7.16 (Q3)
/A4: J1.10, J2.10, J3.9, J4.9, J5.9, J6.9, J7.9, J8.9, U7.15 (Q4)
/A5: J1.11, J2.11, J3.10, J4.10, J5.10, J6.10, J7.10, J8.10, U7.14 (Q5)
/A6: J1.12, J2.12, J3.11, J4.11, J5.11, J6.11, J7.11, J8.11, U7.13 (Q6)
/A7: J1.13, J2.13, J3.12, J4.12, J5.12, J6.12, J7.12, J8.12, U7.12 (Q7)
/A8: J1.14, J2.14, J3.13, J4.13, J5.13, J6.13, J7.13, J8.13, U5.8 (A8)
/A9: J1.15, J2.15, J3.14, J4.14, J5.14, J6.14, J7.14, J8.14, U5.7 (A9)
/A10: J1.16, J2.16, J3.15, J4.15, J5.15, J6.15, J7.15, J8.15, U5.6 (A10)
/A11: J1.17, J2.17, J3.16, J4.16, J5.16, J6.16, J7.16, J8.16, U5.5 (A11)
/A12: J1.18, J2.18, U2.9, U5.4 (A12), U8.5 (~E1)
/A13: J1.19, J2.19, U5.3 (A13), U8.1 (A0), U9.1 (A0)
/A14: J1.20, J2.20, U5.2 (A14), U8.2 (A1), U9.2 (A1)
/A15: J1.21, J2.21, U1.13, U2.3, U5.39 (A15), U8.3 (A2), U9.3 (A2)
/A16: J1.22, J2.22, U6.19 (Q0)
/A17: J1.23, J2.23, U6.18 (Q1)
/A18: U1.2, U6.17 (Q2)
/A19: U1.1, U6.16 (Q3)
/CTRL.IR0: J3.4, R5.2, U3.18 (IR0)
/CTRL.IR1: J4.4, R2.2, U3.19 (IR1)
/CTRL.IR2: J5.4, R6.2, U3.20 (IR2)
/CTRL.IR3: J6.4, R1.2, U3.21 (IR3)
/CTRL.IR4: J7.4, R4.2, U3.22 (IR4)
/CTRL.IR5: J8.4, R7.2, U3.23 (IR5)
/CTRL.RD: J1.1, J2.1, J3.2, J4.2, J5.2, J6.2, J7.2, J8.2, U3.3 (~RD), U5.32 (~RD), U9.4 (~E0)
/CTRL.WR: J1.2, J2.2, J3.3, J4.3, J5.3, J6.3, J7.3, J8.3, U3.2 (~WR), U5.29 (~WR)
/D0: J1.25, J2.25, J3.18, J4.18, J5.18, J6.18, J7.18, J8.18, U3.11 (D0), U5.16 (AD0), U7.2 (D0), U11.18 (Y0)
/D1: J1.26, J2.26, J3.19, J4.19, J5.19, J6.19, J7.19, J8.19, U3.10 (D1), U5.15 (AD1), U7.3 (D1), U11.17 (Y1)
/D2: J1.27, J2.27, J3.20, J4.20, J5.20, J6.20, J7.20, J8.20, U3.9 (D2), U5.14 (AD2), U7.4 (D2), U11.16 (Y2)
/D3: J1.28, J2.28, J3.21, J4.21, J5.21, J6.21, J7.21, J8.21, U3.8 (D3), U5.13 (AD3), U7.5 (D3), U11.15 (Y3)
/D4: J1.29, J2.29, J3.22, J4.22, J5.22, J6.22, J7.22, J8.22, U3.7 (D4), U5.12 (AD4), U7.6 (D4), U11.14 (Y4)
/D5: J1.30, J2.30, J3.23, J4.23, J5.23, J6.23, J7.23, J8.23, U3.6 (D5), U5.11 (AD5), U7.7 (D5), U11.13 (Y5)
/D6: J1.31, J2.31, J3.24, J4.24, J5.24, J6.24, J7.24, J8.24, U3.5 (D6), U5.10 (AD6), U7.8 (D6), U11.12 (Y6)
/D7: J1.32, J2.32, J3.25, J4.25, J5.25, J6.25, J7.25, J8.25, U3.4 (D7), U5.9 (AD7), U7.9 (D7), U11.11 (Y7)
/D+: J9.A6 (D+), J9.B6 (D+), J10.2
/D-: J9.A7 (D-), J9.B7 (D-), J10.3
/RAM1_CS: J1.3, J2.3, U1.8
/RAM2_CS: J1.4, J2.4, U1.11
/ROM_CS: J1.5, J2.5, U1.3, U1.4
GND: C1.2, C2.2, C3.2, C4.2, C5.2, C6.2, C7.2, C8.2, C9.2, C10.2, C11.2, C12.2, D2.1 (K), J1.34, J2.34, J3.28, J4.28, J5.28, J6.28, J7.28, J8.28, J9.A1 (GND), J9.A12 (GND), J9.B1 (GND), J9.B12 (GND), J9.SH (SHIELD), J10.1, J10.4, J10.MP (MountPin), R1.1, R2.1, R3.1, R4.1, R5.1, R6.1, R7.1, R8.1, R10.1, R11.2, R12.2, R16.2, R17.2, R18.2, R19.2, R20.2, R21.2, R22.2, R23.2, R24.2, SW1.2, U1.7 (GND), U2.7 (GND), U3.14 (GND), U3.24 (IR6), U3.25 (IR7), U4.1 (CSYNC), U4.9 (GND), U4.13 (F/~C), U4.14 (EFI), U4.15 (~ASYNC), U5.1 (GND), U5.20 (GND), U5.31 (HOLD), U6.1 (OE), U6.6 (D4), U6.7 (D5), U6.8 (D6), U6.9 (D7), U6.10 (GND), U7.1 (OE), U7.10 (GND), U8.4 (~E0), U8.8 (GND), U9.8 (GND), U10.4 (V-), U11.10 (GND)
unnamed: C4.1, D1.2 (A), J3.26, J4.26, J5.26, J6.26, J7.26, J8.26, R9.2, SW1.1, U4.11 (~RES)
unnamed: D2.2 (A), R13.2
unnamed: J3.1, U8.15 (~Y0)
unnamed: J3.17, U9.15 (~Y0)
unnamed: J4.1, U8.14 (~Y1)
unnamed: J4.17, U9.14 (~Y1)
unnamed: J5.1, U8.13 (~Y2)
unnamed: J5.17, U9.13 (~Y2)
unnamed: J6.1, U8.12 (~Y3)
unnamed: J6.17, U9.12 (~Y3)
unnamed: J7.1, U8.11 (~Y4)
unnamed: J7.17, U9.11 (~Y4)
unnamed: J8.1, U8.10 (~Y5)
unnamed: J8.17, U9.10 (~Y5)
unnamed: J9.A5 (CC1), R11.1, U10.2 (-)
unnamed: J9.B5 (CC2), R12.1, U10.6 (-)
unnamed: C11.1, J9.A4 (VBUS), J9.A9 (VBUS), J9.B4 (VBUS), J9.B9 (VBUS), J10.5, Q1.3 (S), R14.2, R15.1, U10.8 (V+)
unnamed: Q1.1 (G), R14.1, U10.1, U10.7
unnamed: U1.5, U2.2
unnamed: U1.6, U2.13
unnamed: U1.9, U2.4
unnamed: U1.10, U1.12, U2.12
unnamed: U3.17 (INT), U5.18 (INTR)
unnamed: U3.1 (~CS), U8.7 (~Y7)
unnamed: U3.26 (~INTA), U5.24 (~INTA)
unnamed: U4.8 (CLK), U5.19 (CLK)
unnamed: U4.5 (READY), U5.22 (READY)
unnamed: U4.10 (RESET), U5.21 (RESET)
unnamed: R3.2, U4.17 (X1), Y1.1
unnamed: R8.2, U4.16 (X2), Y1.2
unnamed: U5.38 (A16/S3), U6.2 (D0)
unnamed: U5.37 (A17/S4), U6.3 (D1)
unnamed: U5.36 (A18/S5), U6.4 (D2)
unnamed: U5.35 (A19/S6), U6.5 (D3)
unnamed: U5.25 (ALE), U6.11 (Load), U7.11 (Load)
unnamed: U2.1, U5.28 (IO/~M), U8.6 (E2), U9.6 (E2)
unnamed: R10.2, SW2.2, U5.17 (NMI)
unnamed: U2.8, U9.5 (~E1)
unnamed: R15.2, R16.1, U10.3 (+), U10.5 (+)
unnamed: R17.1, R18.1, SW3.15, SW3.16, U11.2 (A0), U11.3 (A1)
unnamed: R19.1, R20.1, SW3.13, SW3.14, U11.4 (A2), U11.5 (A3)
unnamed: R21.1, R22.1, SW3.11, SW3.12, U11.6 (A4), U11.7 (A5)
unnamed: R23.1, R24.1, SW3.9, SW3.10, U11.8 (A6), U11.9 (A7)
unnamed: U8.9 (~Y6), U11.1 (G1), U11.19 (G2)
VCC: C1.1, C2.1, C3.1, C5.1, C6.1, C7.1, C8.1, C9.1, C10.1, C12.1, D1.1 (K), J1.33, J2.33, J3.27, J4.27, J5.27, J6.27, J7.27, J8.27, Q1.2 (D), R9.1, R13.1, SW2.1, SW3.1, SW3.2, SW3.3, SW3.4, SW3.5, SW3.6, SW3.7, SW3.8, U1.14 (VCC), U2.5, U2.11, U2.14 (VCC), U3.16 (~SP/~EN), U3.28 (VCC), U4.3 (~AEN1), U4.7 (~AEN2), U4.18 (VCC), U5.23 (~TEST), U5.33 (MN/~MX), U5.40 (VCC), U6.20 (VCC), U7.20 (VCC), U8.16 (VCC), U9.16 (VCC), U11.20 (VCC)

Notes on the sheet:
Memory Slots
CPU and signal processing
I/O Peripherals
4.32kOhm
715ohm
5.1kOhm resistors
~0.7V output

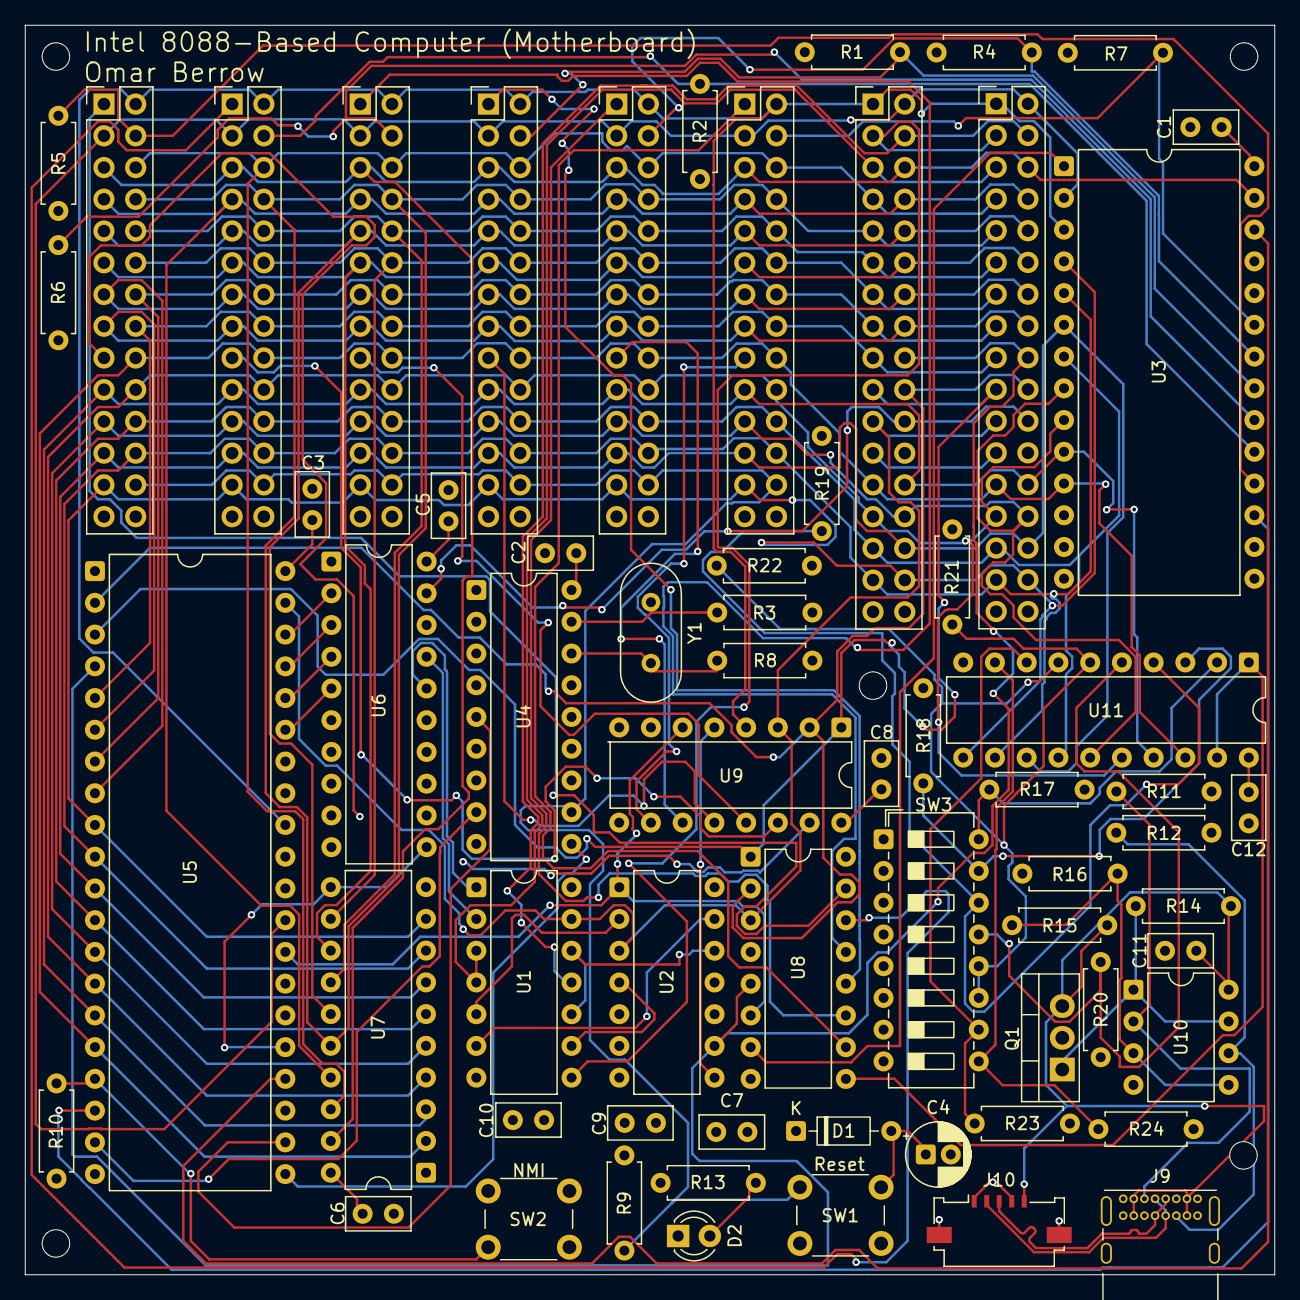
[picture p14: board Intel_8088_Computer.kicad_pcb from above]

Board: 4 copper layers, 100.0 x 100.0 mm, 69 parts (0 on the bottom side), 87 nets.
