oberrow/i8088-computer/kicad/AS6C62256_RAM_Unit/AS6C62256_RAM_Unit.kicad_pcb

## KiCad design kicad/AS6C62256_RAM_Unit/AS6C62256_RAM_Unit.kicad_pcb (2026-07-20)

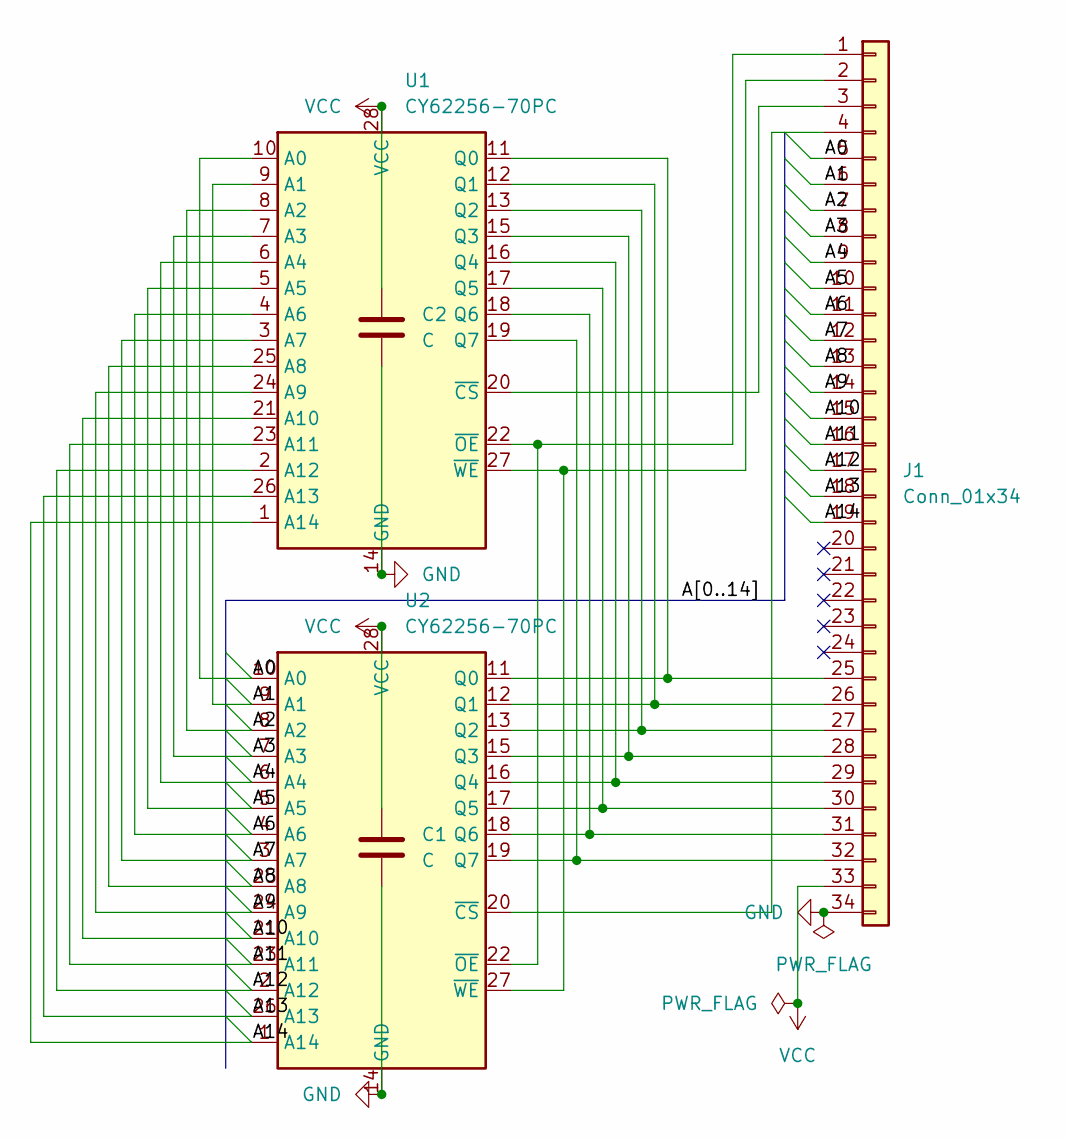
[picture p15: schematic AS6C62256_RAM_Unit.kicad_sch]

Parts:
C1, C2: C; C_Disc_D5.0mm_W2.5mm_P2.50mm
J1: Conn_01x34; PinHeader_2x17_P2.54mm_Vertical
U1, U2: CY62256-70PC; DIP-28_W15.24mm

Connections:
/A0: J1.5, U1.10 (A0), U2.10 (A0)
/A1: J1.6, U1.9 (A1), U2.9 (A1)
/A2: J1.7, U1.8 (A2), U2.8 (A2)
/A3: J1.8, U1.7 (A3), U2.7 (A3)
/A4: J1.9, U1.6 (A4), U2.6 (A4)
/A5: J1.10, U1.5 (A5), U2.5 (A5)
/A6: J1.11, U1.4 (A6), U2.4 (A6)
/A7: J1.12, U1.3 (A7), U2.3 (A7)
/A8: J1.13, U1.25 (A8), U2.25 (A8)
/A9: J1.14, U1.24 (A9), U2.24 (A9)
/A10: J1.15, U1.21 (A10), U2.21 (A10)
/A11: J1.16, U1.23 (A11), U2.23 (A11)
/A12: J1.17, U1.2 (A12), U2.2 (A12)
/A13: J1.18, U1.26 (A13), U2.26 (A13)
/A14: J1.19, U1.1 (A14), U2.1 (A14)
GND: C1.2, C2.2, J1.34, U1.14 (GND), U2.14 (GND)
unnamed: J1.1, U1.22 (~OE), U2.22 (~OE)
unnamed: J1.2, U1.27 (~WE), U2.27 (~WE)
unnamed: J1.3, U1.20 (~CS)
unnamed: J1.4, U2.20 (~CS)
unnamed: J1.25, U1.11 (Q0), U2.11 (Q0)
unnamed: J1.26, U1.12 (Q1), U2.12 (Q1)
unnamed: J1.27, U1.13 (Q2), U2.13 (Q2)
unnamed: J1.28, U1.15 (Q3), U2.15 (Q3)
unnamed: J1.29, U1.16 (Q4), U2.16 (Q4)
unnamed: J1.30, U1.17 (Q5), U2.17 (Q5)
unnamed: J1.31, U1.18 (Q6), U2.18 (Q6)
unnamed: J1.32, U1.19 (Q7), U2.19 (Q7)
VCC: C1.1, C2.1, J1.33, U1.28 (VCC), U2.28 (VCC)

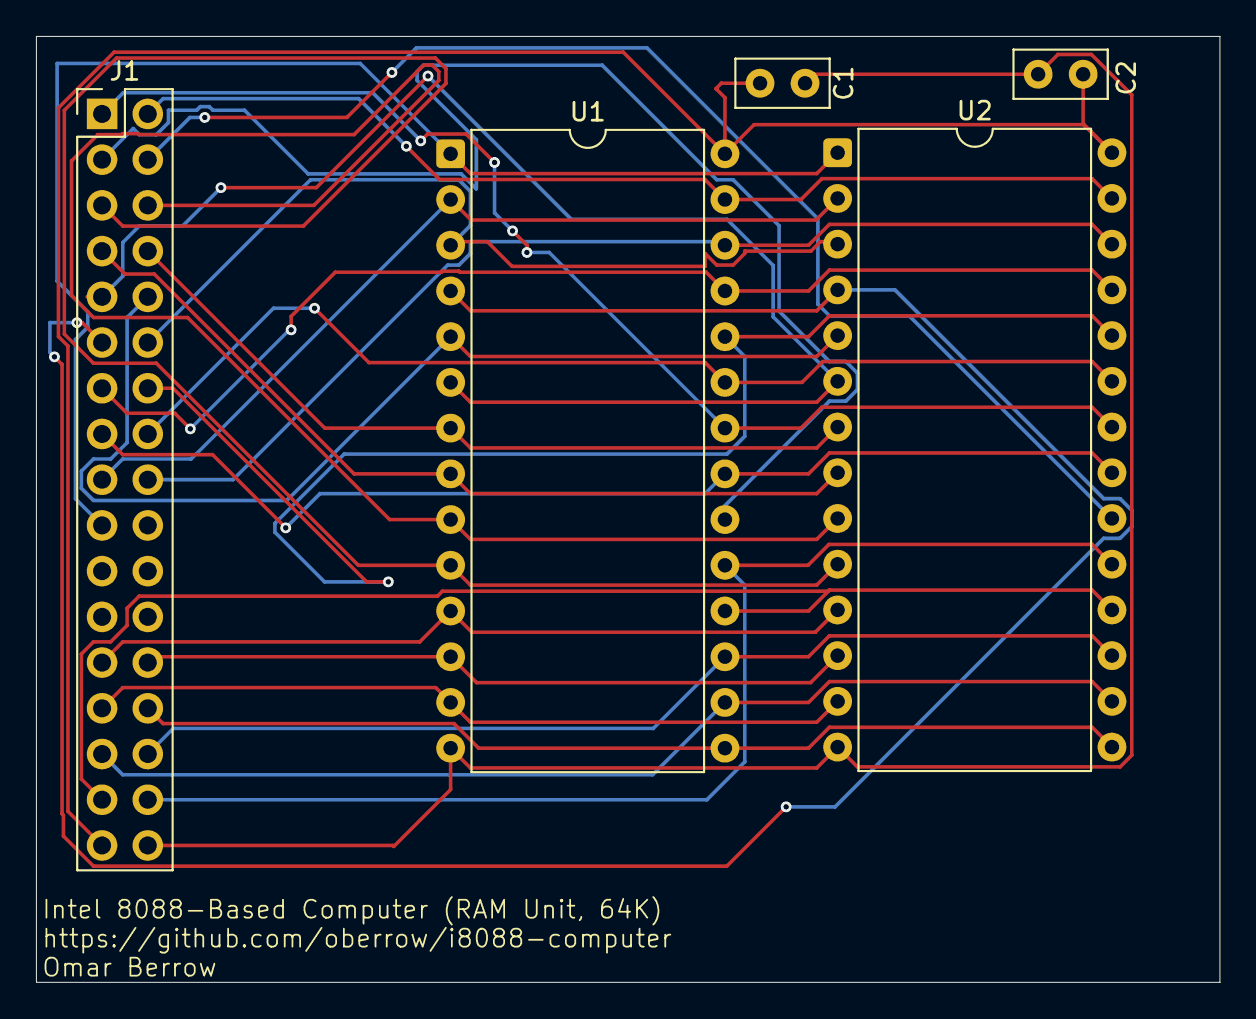
[picture p16: board AS6C62256_RAM_Unit.kicad_pcb from above]

Board: 2 copper layers, 65.8 x 52.5 mm, 5 parts (0 on the bottom side), 29 nets.
