oberrow/i8088-computer/(commit log)

2026-04-25 misc: add CPU 8086 directive to all assembly code
2026-04-26 uart: add basic uart driver
2026-04-26 misc: initialize uart in main.c
2026-04-26 lcd: implement 1602 LCD driver
    Drives the HD44780U chip, specifically.
2026-04-28 misc: fix bug in linker script
    [entry.asm]
2026-04-28 irq: fix bug with int_handler_common
    [ivt.asm]
2026-04-28 misc: fix bug with reset vector code
    [entry.asm]
2026-04-28 misc: print hello world on entry
2026-04-29 misc: fix relocation errors
    [main.c]
2026-04-29 timer: add clock source
2026-04-29 misc: do not print CRNL on LCD screen
2026-04-29 misc: write error messages to uart on exception
    [except.c]
2026-05-18 misc: add gdbstub and fix bugs
    [except.c, extra.h, gdb.c, io.asm, io.h, ivt.asm, main.c, mem.asm]
2026-05-18 uart: change divisor to account for changed 16550 crystal frequency
    Physically, the crystal was going to be a 12mhz crystal, but it is being changed to a standard 1.8432mhz crystal.
2026-06-29 io: adapt to new motherboard chipset and address decoding logic and implement an i8255 driver
    The PCB version of the breadboard computer differs from the breadboard greatly. Firstly, the address decoding logic was essentially overhauled, and probing was supported. I/O Slots exist on the PCB version, and these slots are probed in the new code. RAM is also probed here, although, only 64K of RAM will really ever exist.
2026-06-29 spi: add bitbanging code for SPI
2026-06-29 spi: add spi_pulse
2026-06-29 sd: add SPI SD card driver
    Code is currently untested
2026-06-30 misc: fix bug with memcpy_far
    [mem.asm]
2026-06-30 uart: fix bug in driver
    [uart.c]
2026-06-30 io: fix bug in probing code
    [probe.c]
2026-06-30 misc: fix bug in entry code
    [entry.asm]
2026-06-30 misc: add bootloader handoff code
    Sector zero of the SD card is the boot sector. Trailing bytes should be 0x8088 (LE) to be recognized as a bootable device in the eyes of this firmware. This commit also generates a memory map and I/O space map.
2026-06-30 misc: make flat assembly test occupy the full 256KiB of flash
2026-07-01 sd, spi: fix bugs in sd and spi drivers
    [sd.c, spi.c, spi.h]
2026-07-01 io: fix bug in ram size probing, probe ram size when NO_PROBE is defined
    [probe.c]
2026-07-01 spi: fix MOSI and CLK definitions
    [spi.h]
2026-07-19 spi: add support for new SPI controller added
    SPI Bitbanging is still supported if SPI_BITBANG is defined
2026-07-20 misc: add kicad schematics and PCB designs to repository
    [82C55_GPIO_Unit.kicad_pcb, 82C55_GPIO_Unit.kicad_sch, 97503A111_Stainless Steel Phillips Oval Head Thread-Cutting Screws.STEP, AS6C1008_RAM_Unit.kicad_pcb, AS6C1008_RAM_Unit.kicad_sch, AS6C62256_RAM_Unit.kicad_pcb, AS6C62256_RAM_Unit.kicad_sch, Intel_8088_Computer.kicad_pcb]
