oberrow/i8088-computer/(notices)

Notices in the files:
kicad/Intel_8088_Computer/3dmodels/USB4110-GF-A.step:
author */ ('License CC BY-ND 4.0'),
